wa1hco/rotator_controller/docs/design/drive-controller.md

# Drive controller

Design note, 2026-10-17, with the startup and brownout section added 2026-10-18. The decision records are [ADR 0020](../decisions/0020-drive-controller.md), status Accepted, and [ADR 0021](../decisions/0021-drive-startup-brownout.md), status Accepted. The 2026-10-18 schematic edit follows ADR 0021. The Drive sheets (`drive_mcu`, `analog_input`) and the pin table below were added after that. Firmware is unchanged.

The board gains a second MCU, the Drive. It is the virtual rotator: a short command interface, every deadline, and the same behavior when the STM32F407 is off, busy, or in the middle of an update. The F407 becomes the Station. It keeps the web UI, USB, Ethernet, GS-232, Hamlib, Easycom, the operator preset catalog, logging, parking schedules, multi-rotator, and firmware updates for both chips.

The principle for the split is: deadlines live in the Drive.

Decided in ADR 0020: the names Drive and Station; an AC axis is on or off, so its ramp time is 0; K1 stays, one ARM relay on the first board, because it is the only way to take a shorted triac off the bus; TR1, the ZMCT103C, stays as drawn; the heartbeat default is 5 seconds (allowed 2–30) and the default loss policy is stop; the Drive MCU is the STM32G431RBT6, LCSC C431633. ADR 0020 left ARM_OK as the residual gate. ADR 0021 accepts direct Drive pins, BOR level 4, and a hardware IWDG, and takes the supervisor and the Drive STOP pin off the rotor sheet. The rotor sheet matches that record. Section 8 is what is still open.

## 1. Names

**Drive** is the new MCU. **Station** is the STM32F407.

| Name | Chip | The word covers |
| --- | --- | --- |
| Drive | the new MCU | motors, sensing, brakes, and every deadline |
| Station | STM32F407VGT6, the chip in ADR 0014 | web UI, USB, Ethernet, operator protocols, logging, schedules, multi-rotator, updates |

The product is already called the rotator controller. Drive is the chip that fires the triacs, times the reversal, and still holds the limits when the Station is down. Station is the chip that faces the shack.

## 2. Who owns what

Deadlines live in the Drive. A deadline here means a time after which the hardware must already have done something: dead time before a reverse, ramp, brake release and engage, soft-limit stop, stall, jam, run timeout, and the heartbeat. The Station may be occupied with Ethernet, USB, the web UI, or a firmware upgrade. Those tasks do not extend a Drive deadline.

| Work | Drive | Station |
| --- | --- | --- |
| CW, CCW, and brake triac gates; ARM relay | owns | |
| Reversal dead time | owns | |
| Ramp states. AC ramp time is 0, so the axis is on or off. A real slope is the later DC H-bridge module (ADR 0018). | owns the states | |
| Soft limits and the overlap choice | owns | displays |
| Stall, jam, run timeout | owns | displays and logs |
| Position: pot ADC, filtering, calibration, pulse and quadrature inputs | owns | displays |
| Goto, jog, stop, and park execution | owns | translates GS-232, Hamlib, Easycom, and the web UI into those commands |
| Heartbeat and the loss policy | enforces | sends |
| Limits, calibration, park heading, ramps, deadlines, loss policy | flash copy that runs | operator copy and the preset catalog |
| The other chip off or wedged | runs the stored config and the loss policy | can reset and reflash the Drive; does not gate the triacs |
| Web UI, USB, Ethernet | | owns |
| GS-232, Hamlib, Easycom | | owns |
| Logging, parking schedules, multi-rotator | | owns |
| Firmware update | receives its image over the link | owns both updates |

Azimuth and elevation are two instances of one state machine. Elevation adds a second instance and, when the rotor needs it, a second power stage. ADR 0008 stays: an azimuth-only board leaves the elevation power stage unpopulated. The elevation machine stays in IDLE and reports itself absent.

One Drive serves one rotator (one or two axes) on one UART. A second rotator is a second Drive and a second UART on the Station. That is how multi-rotator stays a Station concern.

## 3. Link to the Station

### Physical layer

Both MCUs use the rotor-return ground. ADR 0018 set logic ground to CDE terminal 1 and left no isolated DC-DC between logic chips. USB stays isolated by the ADuM4160. Ethernet stays isolated by the MagJack. The Drive-to-Station link is on that same ground: 3.3 V, no isolator, no level shifter.

That ground is also the motor return. The link is a short trace, with the two chips placed near each other.

| Link | Wires | Fit |
| --- | --- | --- |
| UART | TX, RX, and the shared ground | Recommended. Either chip can send a status frame. A ground bounce corrupts a byte, and the CRC drops that frame. |
| SPI | SCK, MOSI, MISO, CS | Workable on a short board. Two extra wires, and a clocked transfer is an easy place to start streaming motion samples. The commands in this note are targets with an acknowledgement. |
| I2C | SCL, SDA | A poor fit on a motor return. A spike becomes an extra clock, and the protocol has no frame CRC. |

Assumption: 115200 baud, 8 data bits, no parity, one stop bit, using the MCU's internal oscillator. A crystal is optional; none is required for this baud on a short link.

### Frame

Proposed version 1:

| Field | Bytes | Contents |
| --- | --- | --- |
| SOF | 1 | `0xA5` |
| VER | 1 | `0x01` |
| SEQ | 1 | Host command sequence. Unsolicited status uses `0`. |
| OPCODE | 1 | Below. |
| LEN | 1 | Payload length, 0 to 128. |
| PAYLOAD | LEN | |
| CRC | 2 | CRC-16/CCITT-FALSE, polynomial `0x1021`, init `0xFFFF`, over VER through the payload, high byte first. |

Assumption: that CRC. A damaged frame is dropped with no reply, because the SEQ byte may be the damaged one.

### Sequence numbers

The Station sends one command and waits for the ACK of that SEQ. A retry repeats the same SEQ. The Station sends the next SEQ only after that ACK, and it retries only the SEQ it is waiting on.

The Drive stores `last_seq`. After reset, `last_seq` is 0 and the first CRC-good command may carry any non-zero SEQ. That value becomes `last_seq`.

Later frames:

- `SEQ == last_seq`: duplicate. ACK, and leave the payload unapplied.
- `SEQ == last_seq + 1` modulo 256, skipping 0: apply, then store it.
- any other SEQ: NACK `BAD_SEQ`. Leave the state and `last_seq` alone. The frame is not a heartbeat.

Unsolicited status uses SEQ 0 and stands outside that counter.

A lost command is retried under the same SEQ and applied once. A duplicate is acknowledged and applied once. After a newer SEQ has been accepted, an older SEQ is `BAD_SEQ` and cannot replace the newer target.

Each command names a target. GOTO replaces the heading. JOG replaces the direction and the speed. STOP replaces the goal with stopped. A late, repeated, or missing copy leaves the Drive on the last accepted target. The Drive does not integrate steps.

### Order inside a good frame

1. Apply the SEQ rules above.
2. HEARTBEAT, READ_STATUS, or any command while `host_lost` is clear: apply `heartbeat_ok` first.
3. A motion or config command while `host_lost` is set: NACK `HOST_LOST`. That frame does not clear the flag.
4. Otherwise apply the opcode as the event in the state table.

On a live link, a command refreshes the heartbeat. After a loss, only HEARTBEAT or READ_STATUS clears `host_lost`. The following command is then accepted. That is the "ignore new commands until the heartbeat returns" rule.

### Command set

Proposed opcodes:

| Opcode | Code | Payload |
| --- | --- | --- |
| HEARTBEAT | `0x01` | empty |
| GOTO | `0x02` | axis mask, azimuth in 0.01°, elevation in 0.01°, each a signed 32-bit value |
| STOP | `0x03` | axis mask |
| JOG | `0x04` | one axis bit, direction, speed in permille (`uint16`, 0–1000) |
| PARK | `0x05` | axis mask. The heading is the park value in Drive flash. |
| SET_LIMITS | `0x06` | axis, minimum, maximum, overlap flag |
| SET_CALIBRATION | `0x07` | axis, sensor kind, end readings, end headings. Byte layout TBD. |
| SET_PRESET | `0x08` | axis, park heading |
| SET_MOTION | `0x09` | ramp time (0 on an AC axis), creep window, target window, dead time, brake times, stall, jam, run timeout, heartbeat, loss policy |
| READ_STATUS | `0x0A` | empty. The ACK carries the status record. |
| CLEAR_FAULT | `0x0B` | axis mask |
| ENTER_BOOTLOADER | `0x0C` | a 32-bit magic. The constant is TBD, so a damaged payload cannot enter the bootloader. |
| STATUS | `0x10` | unsolicited status, SEQ 0 |
| ACK | `0x80` | echoes SEQ |
| NACK | `0x7F` | echoes SEQ and a reason byte |

NACK reasons: `BAD_SEQ`, `BAD_STATE`, `HOST_LOST`, `LIMIT`, `BAD_CONFIG`, `FAULT`, `AXIS_ABSENT`, `BAD_MAGIC`.

An AC axis is on or off. Its ramp time is 0, and CREEP commands the same full-on direction gate as RUN. Permille speed and a non-zero ramp belong to the later DC H-bridge module. The states in section 4 still run, and on AC the ramp states pass straight through. Heading unit and the permille encoding are still open (section 8).

Axis bit 0 is azimuth. Bit 1 is elevation.

`SET_LIMITS`, `SET_CALIBRATION`, `SET_PRESET`, and `SET_MOTION` are one event in the state table, `cmd_set_config`. They stay separate opcodes on the wire. A valid write replaces those fields and updates the config CRC. A duplicate SEQ does not write flash again.

### Status

READ_STATUS returns the record below. The Drive also sends it unsolicited. Assumption: every 100 ms while any axis has a heartbeat armed, and every 1 s in BOOT, IDLE, and FAULT.

Per axis: state, parked flag, direction, heading and a valid flag, target, held target (set when hold-on-loss abandons a goto), speed, dead time remaining, brake time remaining, ramp time remaining, CW and CCW limit flags, fault bits, `host_lost`, the loss policy, and a present flag.

Shared: current-transformer reading as raw ADC counts and as milliamps using the burden equation; config CRC-32; firmware major, minor, patch, and build id; protocol version; `last_seq`; FLASH_OPTR, so the Station can check the option bytes in ADR 0021.

DESIGN-NOTES already flags CT saturation at motor-plus-brake current. The milliamp field inherits that limit.

### Faults and flags

Latched fault bits. `clear_fault` clears a bit only when its cause is gone, and the axis stays in FAULT while any bit remains.

| Bit | When it sets |
| --- | --- |
| `CONFIG` | The stored config fails its check. |
| `STALL` | A direction gate is on and the heading stays inside the stall window for the stall time. A low-current detector can set the same bit. Thresholds TBD. |
| `JAM` | Current above the jam threshold. |
| `RUN_TIMEOUT` | This move has exceeded the configured maximum run. |
| `SENSOR` | The pot sample is outside the calibrated range, or the pulse input fails its check. |
| `STUCK_TRIAC` | Stuck-on sense says that triac is conducting after its gate has been off for 20 ms. That interval is the one already in DESIGN-NOTES. |
| `STOP` | A STOP command from the Station is accepted while the core is running. |
| `BOTH_ON` | The output step was asked for CW and CCW together. The state table does not ask for that. The check is defensive. |
| `OPTION_BYTES` | FLASH_OPTR disagrees with ADR 0021. The Drive leaves the outputs safe and the Station does not arm. |

`STUCK_TRIAC`, `JAM`, `SENSOR`, `STOP`, `CONFIG`, `STALL`, `RUN_TIMEOUT`, `BOTH_ON`, and `OPTION_BYTES` force the safe outputs in the same tick: both direction gates off, brake engaged, ARM relay open. They do not ramp down. Opening the ARM relay takes a shorted triac off the 26 VAC bus.

Flags, which are not faults: `HOST_LOST`, the two soft-limit flags, and `PARKED`.

## 4. Heartbeat and the axis machine

The host heartbeat is a deadline of seconds. The Drive's hardware independent watchdog is the separate, faster timer (about 100 ms once firmware has written the reload). A stuck Drive is that watchdog.

The heartbeat default is 5 seconds, set per rotor, allowed range 2 to 30 seconds. The default loss policy is stop. Hold and complete-the-move stay available as per-rotor settings.

The deadline arms when a move is accepted and disarms on entry to IDLE. An idle axis and a parked axis have no heartbeat deadline.

| Policy | Result of a missed heartbeat |
| --- | --- |
| stop | Leave the direction through `RAMP_DOWN` (immediate when the ramp time is 0), engage the brake, enter IDLE, set `host_lost`, and drop the goal. |
| hold | The same motion as stop. The abandoned heading stays in `held_target` for the Station to display. The axis does not continue. |
| complete | The goto or park already underway runs to IDLE. New commands wait for `heartbeat_ok`. A jog has no target, so a jog takes the stop path. |

### Outputs

Brake gate high means the solenoid releases the wedge, matching DESIGN-NOTES. Gate low means the wedge is engaged.

| State | Direction gates | Brake | ARM relay |
| --- | --- | --- | --- |
| BOOT | off | engaged | off |
| IDLE | off | engaged | off |
| BRAKE_RELEASE | off | releasing | on |
| RAMP_UP | one direction | released | on |
| RUN | one direction | released | on |
| CREEP | one direction | released | on |
| RAMP_DOWN | that same direction until `ramp_done`, then off | released | on |
| DEAD_TIME | off | released | on |
| BRAKE_ENGAGE | off | engaging | on until IDLE |
| FAULT | off | engaged | off |

CW and CCW are never both on. A tick that would turn both on latches `BOTH_ON` and enters FAULT.

An AC axis has ramp time 0. `RAMP_UP` and `RAMP_DOWN` are still entered, and `ramp_done` follows on the next tick, with the direction gate full on and then full off. A slope, and a creep speed below full on, are the later DC H-bridge module.

Dead time floor: 500 ms, the value already compiled in as `reversal_dead_time_ms` and `MotionConfig::dead_time_ms`. Changing the pending direction restarts the full interval. The interval is never shortened. STOP during `DEAD_TIME` waits the interval out, because a triac can stay latched until current zero.

Assumption, still open: during a reversal the brake stays released through `DEAD_TIME`, and it engages on the way to IDLE. Brake release and brake engage times are config fields. Their values are TBD. The 50 ms arm time and 150 ms stop time in the current host test are code defaults, not measured solenoid times.

Parked is a flag on IDLE. It is set when a park goal reaches IDLE inside the park window.

Overlap is chosen when a goto or park is accepted, from the heading, the target, the soft limits, and the overlap flag. The machine stores the choice as the direction.

One axis of the Drive. Solid edges are the motion path. Dashed edges are heartbeat loss under stop or hold. A complete-move loss stays on the solid path. Dotted edges are faults. On AC, RAMP_UP and RAMP_DOWN have ramp time 0.

The drawing is the motion path. The tables below are the full event list. Source for the figure: `docs/design/img/src/drive-controller-fsm.dot`.

These fields are context, not states: the goal (none, goto, jog, park), the direction, the pending direction, `after_ramp` (Stop or Reverse), `host_lost`, `held_target`, `parked`, and the loss policy.

A row is one accepted event. A duplicate SEQ never reaches the table. Command rows still say what happens when `host_lost` is already set, so that edge is visible.

`stop_input` faults every axis. TR1 stays one current transformer on the shared hot. A jam on that reading faults every axis whose gate is on. If no gate is on, it faults both axes, because the current was not commanded. The 5 A rating against about 7.3 A motor-plus-brake, and saturation, stay open. Every other event is per axis. A stuck triac is the triac of that axis.

Each state lists the same 23 events.

### BOOT

Safe outputs. Heartbeat disarmed. Motion commands wait for `boot_ok`.

| Event | Result |
| --- | --- |
| boot_ok | Config CRC valid and the sensor sample is inside its calibrated range: go to IDLE, parked clear, outputs stay safe. Otherwise this event is not raised. |
| config_invalid | Latch CONFIG. Gates off, ARM off, brake engaged, goal cleared. |
| cmd_goto | Reject BAD_STATE. |
| cmd_jog | Reject BAD_STATE. |
| cmd_stop | Reject BAD_STATE. |
| cmd_park | Reject BAD_STATE. |
| cmd_set_config | Reject BAD_STATE. Config changes wait until IDLE or FAULT. |
| cmd_clear_fault | ACK and ignore. No fault bits are set. |
| cmd_bootloader | Reject BAD_STATE. Boot has not finished. A CONFIG fault, once latched, accepts the bootloader from FAULT. |
| heartbeat_ok | Clear host_lost if it was set. Do not arm a deadline. Stay. |
| heartbeat_lost | Ignore. Boot is not a host move, and the heartbeat deadline is disarmed. |
| enter_creep | Ignore. Creep is entered from RUN. |
| target_reached | Ignore. |
| ramp_done | Ignore. |
| dead_time_elapsed | Ignore. |
| brake_time_elapsed | Ignore. |
| hit_soft_limit | Ignore. |
| stall | Ignore. The direction gate is off, so a stall timer is not running. |
| jam | Latch JAM. Gates off, ARM off, brake engaged, goal cleared. |
| run_timeout | Ignore. No move is in progress, so the run timer is disarmed. |
| sensor_fault | Latch SENSOR. Gates off, ARM off, brake engaged, goal cleared. |
| stuck_triac | Latch STUCK_TRIAC. Gates off, ARM off, brake engaged, goal cleared. |
| stop_input | Latch STOP. Gates off, ARM off, brake engaged, goal cleared. |

### IDLE

Brake engaged, ARM off. Heartbeat disarmed. `parked` may be set.

| Event | Result |
| --- | --- |
| boot_ok | Ignore. |
| config_invalid | Latch CONFIG. Gates off, ARM off, brake engaged, goal cleared. |
| cmd_goto | If host_lost is set: reject HOST_LOST and do not clear it. No legal path under the soft limits and the overlap flag: reject LIMIT. Heading already inside the target window: store the target, clear parked, stay. Otherwise clear parked, store the target and direction, arm the heartbeat, and go to BRAKE_RELEASE. |
| cmd_jog | If host_lost is set: reject HOST_LOST and do not clear it. Jog into a limit that is already active: reject LIMIT. Otherwise clear parked, set the jog goal and direction, arm the heartbeat, and go to BRAKE_RELEASE. |
| cmd_stop | ACK. Stay. The parked flag is unchanged. |
| cmd_park | If host_lost is set: reject HOST_LOST and do not clear it. Heading already inside the park window: set parked and stay. No legal path: reject LIMIT. Otherwise clear parked, set the park goal, arm the heartbeat, and go to BRAKE_RELEASE. |
| cmd_set_config | Validate the blob. Valid: store it, recompute the config CRC, stay. Invalid: reject BAD_CONFIG and keep the previous blob. |
| cmd_clear_fault | ACK and ignore. No fault bits are set. |
| cmd_bootloader | Accept. Outputs are already safe. Leave this machine and enter the bootloader. |
| heartbeat_ok | Clear host_lost if it was set. Do not arm a deadline. Stay. |
| heartbeat_lost | Ignore. Do not set host_lost. An idle or parked axis has no heartbeat deadline. A host_lost flag left by the move that just finished stays set until heartbeat_ok. |
| enter_creep | Ignore. Creep is entered from RUN. |
| target_reached | Ignore. |
| ramp_done | Ignore. |
| dead_time_elapsed | Ignore. |
| brake_time_elapsed | Ignore. |
| hit_soft_limit | Set the matching limit flag. Stay. |
| stall | Ignore. The direction gate is off, so a stall timer is not running. |
| jam | Latch JAM. Gates off, ARM off, brake engaged, goal cleared. |
| run_timeout | Ignore. No move is in progress, so the run timer is disarmed. |
| sensor_fault | Latch SENSOR. Gates off, ARM off, brake engaged, goal cleared. |
| stuck_triac | Latch STUCK_TRIAC. Gates off, ARM off, brake engaged, goal cleared. |
| stop_input | Latch STOP. Gates off, ARM off, brake engaged, goal cleared. |

### BRAKE_RELEASE

ARM on, brake releasing, directions off. Heartbeat armed.

| Event | Result |
| --- | --- |
| boot_ok | Ignore. |
| config_invalid | Latch CONFIG. Gates off, ARM off, brake engaged, goal cleared. |
| cmd_goto | If host_lost is set: reject HOST_LOST and do not clear it. Replace the goal with this goto. Update the pending direction. Stay. A heading that is already satisfied takes BRAKE_ENGAGE when the brake timer elapses. |
| cmd_jog | If host_lost is set: reject HOST_LOST and do not clear it. Replace the goal with this jog. Update the pending direction. Stay. A heading that is already satisfied takes BRAKE_ENGAGE when the brake timer elapses. |
| cmd_stop | If host_lost is set: reject HOST_LOST and stay. Otherwise clear the goal and go to BRAKE_ENGAGE. |
| cmd_park | If host_lost is set: reject HOST_LOST and do not clear it. Replace the goal with this park. Update the pending direction. Stay. A heading that is already satisfied takes BRAKE_ENGAGE when the brake timer elapses. |
| cmd_set_config | Reject BAD_STATE. Config changes wait until IDLE or FAULT. |
| cmd_clear_fault | ACK and ignore. No fault bits are set. |
| cmd_bootloader | Reject BAD_STATE. A move is in progress. |
| heartbeat_ok | Clear host_lost. Reload the heartbeat deadline. Stay. |
| heartbeat_lost | Stop: set host_lost, clear the goal and any pending reverse, and take the stop path. Stop path here is BRAKE_ENGAGE. Hold: same path as stop, and keep the abandoned target in held_target. Complete, goal is goto or park: set host_lost and stay on this trajectory. Complete, goal is jog: take the stop path, because a jog has no target. |
| enter_creep | Ignore. Creep is entered from RUN. |
| target_reached | Ignore. |
| ramp_done | Ignore. |
| dead_time_elapsed | Ignore. |
| brake_time_elapsed | Goal cleared, or the heading is already inside the target window: go to BRAKE_ENGAGE. Otherwise go to RAMP_UP with the pending direction. |
| hit_soft_limit | Pending direction runs into that limit: clear the goal, set the flag, go to BRAKE_ENGAGE. Otherwise set the flag and stay. |
| stall | Ignore. The direction gate is off, so a stall timer is not running. |
| jam | Latch JAM. Gates off, ARM off, brake engaged, goal cleared. |
| run_timeout | Latch RUN_TIMEOUT. Gates off, ARM off, brake engaged, goal cleared. |
| sensor_fault | Latch SENSOR. Gates off, ARM off, brake engaged, goal cleared. |
| stuck_triac | Latch STUCK_TRIAC. Gates off, ARM off, brake engaged, goal cleared. |
| stop_input | Latch STOP. Gates off, ARM off, brake engaged, goal cleared. |

### RAMP_UP

One direction on. On AC the ramp time is 0, so `ramp_done` is the next tick and the gate is already full on. A DC H-bridge module is what gives this state a slope.

| Event | Result |
| --- | --- |
| boot_ok | Ignore. |
| config_invalid | Latch CONFIG. Gates off, ARM off, brake engaged, goal cleared. |
| cmd_goto | If host_lost is set: reject HOST_LOST and do not clear it. Same direction and the target window is not already satisfied: replace the target or the jog speed and stay. Opposite direction, or the heading is already inside the window: go to RAMP_DOWN, after_ramp = Reverse or Stop. |
| cmd_jog | If host_lost is set: reject HOST_LOST and do not clear it. Same direction and the target window is not already satisfied: replace the target or the jog speed and stay. Opposite direction, or the heading is already inside the window: go to RAMP_DOWN, after_ramp = Reverse or Stop. |
| cmd_stop | If host_lost is set: reject HOST_LOST and stay. Otherwise clear the goal and any pending reverse, after_ramp = Stop, go to RAMP_DOWN. |
| cmd_park | If host_lost is set: reject HOST_LOST and do not clear it. Same direction and the target window is not already satisfied: replace the target or the jog speed and stay. Opposite direction, or the heading is already inside the window: go to RAMP_DOWN, after_ramp = Reverse or Stop. |
| cmd_set_config | Reject BAD_STATE. Config changes wait until IDLE or FAULT. |
| cmd_clear_fault | ACK and ignore. No fault bits are set. |
| cmd_bootloader | Reject BAD_STATE. A move is in progress. |
| heartbeat_ok | Clear host_lost. Reload the heartbeat deadline. Stay. |
| heartbeat_lost | Stop: set host_lost, clear the goal and any pending reverse, and take the stop path. Stop path here is RAMP_DOWN with after_ramp = Stop. Hold: same path as stop, and keep the abandoned target in held_target. Complete, goal is goto or park: set host_lost and stay on this trajectory. Complete, goal is jog: take the stop path, because a jog has no target. |
| enter_creep | Ignore. Creep is entered from RUN. |
| target_reached | Goto or park inside the target window: clear the direction goal's continue flag, after_ramp = Stop, go to RAMP_DOWN. A jog does not raise this event. |
| ramp_done | Go to RUN. The direction gate stays on. |
| dead_time_elapsed | Ignore. |
| brake_time_elapsed | Ignore. |
| hit_soft_limit | Traveling into that limit: set the flag, clear a pending reverse, after_ramp = Stop, go to RAMP_DOWN. |
| stall | Latch STALL. Gates off, ARM off, brake engaged, goal cleared. |
| jam | Latch JAM. Gates off, ARM off, brake engaged, goal cleared. |
| run_timeout | Latch RUN_TIMEOUT. Gates off, ARM off, brake engaged, goal cleared. |
| sensor_fault | Latch SENSOR. Gates off, ARM off, brake engaged, goal cleared. |
| stuck_triac | Latch STUCK_TRIAC. Gates off, ARM off, brake engaged, goal cleared. |
| stop_input | Latch STOP. Gates off, ARM off, brake engaged, goal cleared. |

### RUN

One direction at the commanded speed.

| Event | Result |
| --- | --- |
| boot_ok | Ignore. |
| config_invalid | Latch CONFIG. Gates off, ARM off, brake engaged, goal cleared. |
| cmd_goto | If host_lost is set: reject HOST_LOST and do not clear it. Same direction and the target window is not already satisfied: replace the target or the jog speed and stay. Opposite direction, or the heading is already inside the window: go to RAMP_DOWN, after_ramp = Reverse or Stop. |
| cmd_jog | If host_lost is set: reject HOST_LOST and do not clear it. Same direction and the target window is not already satisfied: replace the target or the jog speed and stay. Opposite direction, or the heading is already inside the window: go to RAMP_DOWN, after_ramp = Reverse or Stop. |
| cmd_stop | If host_lost is set: reject HOST_LOST and stay. Otherwise clear the goal and any pending reverse, after_ramp = Stop, go to RAMP_DOWN. |
| cmd_park | If host_lost is set: reject HOST_LOST and do not clear it. Same direction and the target window is not already satisfied: replace the target or the jog speed and stay. Opposite direction, or the heading is already inside the window: go to RAMP_DOWN, after_ramp = Reverse or Stop. |
| cmd_set_config | Reject BAD_STATE. Config changes wait until IDLE or FAULT. |
| cmd_clear_fault | ACK and ignore. No fault bits are set. |
| cmd_bootloader | Reject BAD_STATE. A move is in progress. |
| heartbeat_ok | Clear host_lost. Reload the heartbeat deadline. Stay. |
| heartbeat_lost | Stop: set host_lost, clear the goal and any pending reverse, and take the stop path. Stop path here is RAMP_DOWN with after_ramp = Stop. Hold: same path as stop, and keep the abandoned target in held_target. Complete, goal is goto or park: set host_lost and stay on this trajectory. Complete, goal is jog: take the stop path, because a jog has no target. |
| enter_creep | Goal is goto or park and the heading is inside the creep window: go to CREEP. A jog does not raise this event. |
| target_reached | Goto or park inside the target window: clear the direction goal's continue flag, after_ramp = Stop, go to RAMP_DOWN. A jog does not raise this event. |
| ramp_done | Ignore. |
| dead_time_elapsed | Ignore. |
| brake_time_elapsed | Ignore. |
| hit_soft_limit | Traveling into that limit: set the flag, clear a pending reverse, after_ramp = Stop, go to RAMP_DOWN. |
| stall | Latch STALL. Gates off, ARM off, brake engaged, goal cleared. |
| jam | Latch JAM. Gates off, ARM off, brake engaged, goal cleared. |
| run_timeout | Latch RUN_TIMEOUT. Gates off, ARM off, brake engaged, goal cleared. |
| sensor_fault | Latch SENSOR. Gates off, ARM off, brake engaged, goal cleared. |
| stuck_triac | Latch STUCK_TRIAC. Gates off, ARM off, brake engaged, goal cleared. |
| stop_input | Latch STOP. Gates off, ARM off, brake engaged, goal cleared. |

### CREEP

Inside the creep window of a goto or a park. On AC the gate stays full on, the same as RUN. A reduced creep speed is the later DC H-bridge module.

| Event | Result |
| --- | --- |
| boot_ok | Ignore. |
| config_invalid | Latch CONFIG. Gates off, ARM off, brake engaged, goal cleared. |
| cmd_goto | If host_lost is set: reject HOST_LOST and do not clear it. Same direction and the target window is not already satisfied: replace the target or the jog speed and stay. A new goto or park outside the creep window goes to RUN when the direction stays the same. Opposite direction, or the heading is already inside the window: go to RAMP_DOWN, after_ramp = Reverse or Stop. |
| cmd_jog | If host_lost is set: reject HOST_LOST and do not clear it. Same direction and the target window is not already satisfied: replace the target or the jog speed and stay. Opposite direction, or the heading is already inside the window: go to RAMP_DOWN, after_ramp = Reverse or Stop. |
| cmd_stop | If host_lost is set: reject HOST_LOST and stay. Otherwise clear the goal and any pending reverse, after_ramp = Stop, go to RAMP_DOWN. |
| cmd_park | If host_lost is set: reject HOST_LOST and do not clear it. Same direction and the target window is not already satisfied: replace the target or the jog speed and stay. A new goto or park outside the creep window goes to RUN when the direction stays the same. Opposite direction, or the heading is already inside the window: go to RAMP_DOWN, after_ramp = Reverse or Stop. |
| cmd_set_config | Reject BAD_STATE. Config changes wait until IDLE or FAULT. |
| cmd_clear_fault | ACK and ignore. No fault bits are set. |
| cmd_bootloader | Reject BAD_STATE. A move is in progress. |
| heartbeat_ok | Clear host_lost. Reload the heartbeat deadline. Stay. |
| heartbeat_lost | Stop: set host_lost, clear the goal and any pending reverse, and take the stop path. Stop path here is RAMP_DOWN with after_ramp = Stop. Hold: same path as stop, and keep the abandoned target in held_target. Complete, goal is goto or park: set host_lost and stay on this trajectory. Complete, goal is jog: take the stop path, because a jog has no target. |
| enter_creep | Ignore. Creep is entered from RUN. |
| target_reached | Goto or park inside the target window: clear the direction goal's continue flag, after_ramp = Stop, go to RAMP_DOWN. A jog does not raise this event. |
| ramp_done | Ignore. |
| dead_time_elapsed | Ignore. |
| brake_time_elapsed | Ignore. |
| hit_soft_limit | Traveling into that limit: set the flag, clear a pending reverse, after_ramp = Stop, go to RAMP_DOWN. |
| stall | Latch STALL. Gates off, ARM off, brake engaged, goal cleared. |
| jam | Latch JAM. Gates off, ARM off, brake engaged, goal cleared. |
| run_timeout | Latch RUN_TIMEOUT. Gates off, ARM off, brake engaged, goal cleared. |
| sensor_fault | Latch SENSOR. Gates off, ARM off, brake engaged, goal cleared. |
| stuck_triac | Latch STUCK_TRIAC. Gates off, ARM off, brake engaged, goal cleared. |
| stop_input | Latch STOP. Gates off, ARM off, brake engaged, goal cleared. |

### RAMP_DOWN

The direction that was on, then off. On AC the ramp time is 0, so `ramp_done` is the next tick. `ramp_done` starts dead time when a reverse is pending, and engages the brake when the axis is stopping.

| Event | Result |
| --- | --- |
| boot_ok | Ignore. |
| config_invalid | Latch CONFIG. Gates off, ARM off, brake engaged, goal cleared. |
| cmd_goto | If host_lost is set: reject HOST_LOST and do not clear it. Same direction as the ramp in progress: go to RAMP_UP. Opposite direction: stay, after_ramp = Reverse, and set the pending direction. Dead time starts only for that opposite direction, after ramp_done. Heading already inside the window: after_ramp = Stop, stay. |
| cmd_jog | If host_lost is set: reject HOST_LOST and do not clear it. Same direction as the ramp in progress: go to RAMP_UP. Opposite direction: stay, after_ramp = Reverse, and set the pending direction. Dead time starts only for that opposite direction, after ramp_done. Heading already inside the window: after_ramp = Stop, stay. |
| cmd_stop | If host_lost is set: reject HOST_LOST and stay. Otherwise clear the goal and any pending reverse, after_ramp = Stop, stay. |
| cmd_park | If host_lost is set: reject HOST_LOST and do not clear it. Same direction as the ramp in progress: go to RAMP_UP. Opposite direction: stay, after_ramp = Reverse, and set the pending direction. Dead time starts only for that opposite direction, after ramp_done. Heading already inside the window: after_ramp = Stop, stay. |
| cmd_set_config | Reject BAD_STATE. Config changes wait until IDLE or FAULT. |
| cmd_clear_fault | ACK and ignore. No fault bits are set. |
| cmd_bootloader | Reject BAD_STATE. A move is in progress. |
| heartbeat_ok | Clear host_lost. Reload the heartbeat deadline. Stay. |
| heartbeat_lost | Stop: set host_lost, clear the goal and any pending reverse, and take the stop path. Stop path here stays in RAMP_DOWN with after_ramp = Stop. Hold: same path as stop, and keep the abandoned target in held_target. Complete, goal is goto or park: set host_lost and stay on this trajectory. Complete, goal is jog: take the stop path, because a jog has no target. |
| enter_creep | Ignore. Creep is entered from RUN. |
| target_reached | Ignore. |
| ramp_done | Direction gate off. after_ramp is Reverse and a direction is pending: go to DEAD_TIME. Otherwise go to BRAKE_ENGAGE. |
| dead_time_elapsed | Ignore. |
| brake_time_elapsed | Ignore. |
| hit_soft_limit | Set the flag. Force after_ramp = Stop so ramp_done engages the brake. Stay. |
| stall | Direction gate still on: latch STALL, safe outputs. Gate already off: ignore. |
| jam | Latch JAM. Gates off, ARM off, brake engaged, goal cleared. |
| run_timeout | Latch RUN_TIMEOUT. Gates off, ARM off, brake engaged, goal cleared. |
| sensor_fault | Latch SENSOR. Gates off, ARM off, brake engaged, goal cleared. |
| stuck_triac | Latch STUCK_TRIAC. Gates off, ARM off, brake engaged, goal cleared. |
| stop_input | Latch STOP. Gates off, ARM off, brake engaged, goal cleared. |

### DEAD_TIME

Both directions off. Brake stays released. The timer is at least 500 ms and is never shortened.

| Event | Result |
| --- | --- |
| boot_ok | Ignore. |
| config_invalid | Latch CONFIG. Gates off, ARM off, brake engaged, goal cleared. |
| cmd_goto | If host_lost is set: reject HOST_LOST and do not clear it. Replace the goal with this goto and update the pending direction. Stay. Changing the pending direction restarts the full dead-time timer. The timer is never shortened, and RAMP_UP waits for dead_time_elapsed. |
| cmd_jog | If host_lost is set: reject HOST_LOST and do not clear it. Replace the goal with this jog and update the pending direction. Stay. Changing the pending direction restarts the full dead-time timer. The timer is never shortened, and RAMP_UP waits for dead_time_elapsed. |
| cmd_stop | If host_lost is set: reject HOST_LOST and stay. Otherwise clear the goal and the pending direction. Stay. The dead-time timer keeps running, and dead_time_elapsed then goes to BRAKE_ENGAGE. |
| cmd_park | If host_lost is set: reject HOST_LOST and do not clear it. Replace the goal with this park and update the pending direction. Stay. Changing the pending direction restarts the full dead-time timer. The timer is never shortened, and RAMP_UP waits for dead_time_elapsed. |
| cmd_set_config | Reject BAD_STATE. Config changes wait until IDLE or FAULT. |
| cmd_clear_fault | ACK and ignore. No fault bits are set. |
| cmd_bootloader | Reject BAD_STATE. A move is in progress. |
| heartbeat_ok | Clear host_lost. Reload the heartbeat deadline. Stay. |
| heartbeat_lost | Stop: set host_lost, clear the goal and any pending reverse, and take the stop path. Stop path here clears the pending direction and stays until dead_time_elapsed, which then goes to BRAKE_ENGAGE. The timer is not shortened. Hold: same path as stop, and keep the abandoned target in held_target. Complete, goal is goto or park: set host_lost and stay on this trajectory. Complete, goal is jog: take the stop path, because a jog has no target. |
| enter_creep | Ignore. Creep is entered from RUN. |
| target_reached | Ignore. |
| ramp_done | Ignore. |
| dead_time_elapsed | A direction is still pending and the goal was not cleared: go to RAMP_UP. Otherwise go to BRAKE_ENGAGE. |
| brake_time_elapsed | Ignore. |
| hit_soft_limit | Pending direction runs into that limit: clear the pending direction, set the flag, stay. dead_time_elapsed then goes to BRAKE_ENGAGE. |
| stall | Ignore. The direction gate is off, so a stall timer is not running. |
| jam | Latch JAM. Gates off, ARM off, brake engaged, goal cleared. |
| run_timeout | Latch RUN_TIMEOUT. Gates off, ARM off, brake engaged, goal cleared. |
| sensor_fault | Latch SENSOR. Gates off, ARM off, brake engaged, goal cleared. |
| stuck_triac | Latch STUCK_TRIAC. Gates off, ARM off, brake engaged, goal cleared. |
| stop_input | Latch STOP. Gates off, ARM off, brake engaged, goal cleared. |

### BRAKE_ENGAGE

Directions off, wedge engaging. A new move waits until IDLE.

| Event | Result |
| --- | --- |
| boot_ok | Ignore. |
| config_invalid | Latch CONFIG. Gates off, ARM off, brake engaged, goal cleared. |
| cmd_goto | If host_lost is set: reject HOST_LOST and do not clear it. Otherwise reject BAD_STATE. The brake timer finishes before a new move is accepted. The host retries; a retry is the same target. |
| cmd_jog | If host_lost is set: reject HOST_LOST and do not clear it. Otherwise reject BAD_STATE. The brake timer finishes before a new move is accepted. The host retries; a retry is the same target. |
| cmd_stop | If host_lost is set: reject HOST_LOST and stay. Otherwise ACK and stay. The brake timer keeps running. |
| cmd_park | If host_lost is set: reject HOST_LOST and do not clear it. Otherwise reject BAD_STATE. The brake timer finishes before a new move is accepted. The host retries; a retry is the same target. |
| cmd_set_config | Reject BAD_STATE. Config changes wait until IDLE or FAULT. |
| cmd_clear_fault | ACK and ignore. No fault bits are set. |
| cmd_bootloader | Reject BAD_STATE. A move is in progress. |
| heartbeat_ok | Clear host_lost. Reload the heartbeat deadline. Stay. |
| heartbeat_lost | Every policy: set host_lost and stay. The brake timer still runs to IDLE. New motion commands are rejected until heartbeat_ok. |
| enter_creep | Ignore. Creep is entered from RUN. |
| target_reached | Ignore. |
| ramp_done | Ignore. |
| dead_time_elapsed | Ignore. |
| brake_time_elapsed | Go to IDLE. ARM off. Disarm the heartbeat. Goal was park and the heading is inside the park window: set parked. |
| hit_soft_limit | Set the flag. Stay. |
| stall | Ignore. The direction gate is off, so a stall timer is not running. |
| jam | Latch JAM. Gates off, ARM off, brake engaged, goal cleared. |
| run_timeout | Latch RUN_TIMEOUT. Gates off, ARM off, brake engaged, goal cleared. |
| sensor_fault | Latch SENSOR. Gates off, ARM off, brake engaged, goal cleared. |
| stuck_triac | Latch STUCK_TRIAC. Gates off, ARM off, brake engaged, goal cleared. |
| stop_input | Latch STOP. Gates off, ARM off, brake engaged, goal cleared. |

### FAULT

Safe outputs, latched. `clear_fault` returns to IDLE only when every cause is gone.

| Event | Result |
| --- | --- |
| boot_ok | Ignore. |
| config_invalid | Stay. Set CONFIG. |
| cmd_goto | Reject FAULT. |
| cmd_jog | Reject FAULT. |
| cmd_stop | Reject FAULT. |
| cmd_park | Reject FAULT. |
| cmd_set_config | Validate the blob. Valid: store it, recompute the config CRC, stay. Invalid: reject BAD_CONFIG and keep the previous blob. |
| cmd_clear_fault | Clear each fault bit whose cause is gone. No bits left: go to IDLE. Any bit left: stay in FAULT. |
| cmd_bootloader | Accept. Outputs are already safe. Leave this machine and enter the bootloader. |
| heartbeat_ok | Clear host_lost if it was set. Do not arm a deadline. Stay. |
| heartbeat_lost | Ignore. Do not set host_lost. The outputs are already safe. |
| enter_creep | Ignore. Creep is entered from RUN. |
| target_reached | Ignore. |
| ramp_done | Ignore. |
| dead_time_elapsed | Ignore. |
| brake_time_elapsed | Ignore. |
| hit_soft_limit | Ignore. |
| stall | Ignore. The direction gate is off, so a stall timer is not running. |
| jam | Stay. Set JAM. clear_fault leaves the bit set while the cause is present. |
| run_timeout | Ignore. No move is in progress, so the run timer is disarmed. |
| sensor_fault | Stay. Set SENSOR. clear_fault leaves the bit set while the cause is present. |
| stuck_triac | Stay. Set STUCK_TRIAC. clear_fault leaves the bit set while the cause is present. |
| stop_input | Stay. Set STOP. clear_fault leaves the bit set while the cause is present. |

## 5. Hardware

### Drive MCU

The Drive MCU is the STM32G431RBT6. The other two rows are the parts checked against it on the LCSC pages on 2026-10-17. Warehouse stock moves, and it is not a promise. JLC's own assembly stock was not rechecked; confirm it before ordering. ADR 0013 still holds: JLCPCB assembles the SMT parts, so an LQFP does not have to be hand-soldered.

| Part | LCSC | Package | I/O | Core and memory | Analog, as listed on the LCSC page | Warehouse stock | Qty-1 price |
| --- | --- | --- | --- | --- | --- | --- | --- |
| STM32G431RBT6 | [C431633](https://www.lcsc.com/product-detail/C431633.html) | LQFP-64, 10×10 | 52 | Cortex-M4F, 170 MHz, 128 KB flash. The key line says 32 KB SRAM; the feature list splits that into 22 KB SRAM plus 10 KB CCM. | 2 ADCs, 0.25 µs, up to 16-bit with oversampling; 4 comparators; 3 op-amps; VREFBUF at 2.048 V, 2.5 V, or 2.95 V; quadrature encoder timers; 4 USART | 2,572 | $5.7997 |
| STM32G431CBT6 | [C529355](https://www.lcsc.com/product-detail/C529355.html) | LQFP-48, 7×7 | 38 | Same flash and core | Same analog list | 4,642 | $5.1654 |
| STM32G071RBT6 | [C432213](https://www.lcsc.com/product-detail/C432213.html) | LQFP-64, 10×10 | 60 | Cortex-M0+, 64 MHz, 128 KB flash, 36 KB SRAM | One 12-bit ADC, 0.4 µs, up to 16 external channels; two comparators | 788 | not copied off the page |

The Drive is the **STM32G431RBT6, LCSC C431633.** Two ADCs can take the pot ends and the current transformer without folding them into one long scan. The comparators and op-amps are available for the jam path and the pot front end. VREFBUF is a concrete candidate for the ADC reference ADR 0018 left open. Fifty-two I/O pins cover azimuth and elevation with room left. The 48-pin G431 (C529355) and the G071 (C432213) were the parts checked against it on 2026-10-17. JLC assembly stock was not rechecked; confirm it before ordering.

The accepted part is the 128 KB STM32G431RBT6. A 512 KB STM32G474 in LQFP-64 was not opened for this note, and it has no C-number here.

The Station is already an STM32F407 (ADR 0014). The Drive is a second chip. Other MCU families were not given C-numbers here.

### Pins

Assumption: the first board pins both axes. Elevation power parts can stay off the board.

| Function | Azimuth | Elevation | Shared |
| --- | --- | --- | --- |
| CW gate, into the 2N7002, with a pulldown | 1 | 1 | |
| CCW gate | 1 | 1 | |
| Brake gate, high = release | 1 | 1 | |
| ARM relay FET | | | 1 |
| Pot end A, ADC | 1 | 1 | |
| Pot end B, ADC | 1 | 1 | |
| Pulse, or quadrature A, timer input | 1 | 1 | |
| Quadrature B | 1 | 1 | |
| Stuck-on sense, CW, CCW, brake | 3 | 3 | |
| Optional limit inputs | 2 | 2 | |
| Zero-cross | | | 1 |
| Current transformer, ADC | | | 1 |
| UART TX and RX to the Station | | | 2 |
| PB8 / BOOT0. With nSWBOOT0 = 0 (ADR 0021) the boot selection is the option bit. PB8 is not a gate. | | | 1, spare |
| Status LED | | | 1, optional |
| SWDIO, SWCLK, and NRST | | | header |

Without the optional limit inputs that is about 30 signals plus the SWD header. The 64-pin part lists 52 I/O. The 48-pin part lists 38, which covers the cut above and leaves little spare. SWD uses two of those I/O.

The pot wiper is rotor return (ADR 0018). The Drive measures the two ends. A passive 60 Hz twin-T is drawn on each sense line of `analog_input`, ahead of the ADC. The FIR described in the system overview is not written yet. Firmware averaging is not the fix for the 60 Hz that the shared return wire puts on these lines.

### Pin assignment

Drawn on `hardware/controller-f407/drive_mcu.kicad_sch`. Package is LQFP-64. Pin numbers are DS12589 Table 12. Gate pins are high-Z at reset (DS12589 §3.11.5, RM0440 §9.4.1) and one pulldown per line already on `rotor_drive` holds them down: R2G, R3G, R4G, and R40. This sheet does not add another.

These pins are not gates: PA13, PA14, PA15, PB3, PB4 (debug), PG10 (NRST), PB8 (BOOT0, spare while nSWBOOT0 = 0), and every pin AN2606 Table 115 drives or pulls. That includes PA6 and PB14, which the ROM bootloader drives to 3.3 V. Those pins are no-connects on this sheet. PB3 is SWO on the debug header, not a gate.

| Signal | Pin | Use |
| --- | --- | --- |
| `AZ_CW_EN` | PC6, pin 38 | CW gate. High-Z at reset. |
| `AZ_CCW_EN` | PC7, pin 39 | CCW gate. |
| `AZ_BRAKE_EN` | PC12, pin 54 | Brake gate. High releases the wedge. |
| `ARM_EN` | PD2, pin 55 | K1 gate. Low or high-Z leaves the relay open. |
| `ZC_SENSE` | PB5, pin 58 | Zero-cross input. |
| `AZ_CW_SNS` | PC13, pin 2 | Stuck-on sense, CW. |
| `AZ_CCW_SNS` | PC14, pin 3 | Stuck-on sense, CCW. |
| `AZ_BRAKE_SNS` | PC15, pin 4 | Stuck-on sense, brake. |
| `AZ_A_ADC` | PC0, pin 8, ADC12_IN6 | Azimuth pot end A. |
| `AZ_B_ADC` | PC1, pin 9, ADC12_IN7 | Azimuth pot end B. |
| `EL_A_ADC` | PC2, pin 10, ADC12_IN8 | Elevation pot end A. |
| `EL_B_ADC` | PC3, pin 11, ADC12_IN9 | Elevation pot end B. |
| `I_SENSE` | PA0, pin 12, ADC12_IN1 | TR1, after the conditioning on `rotor_drive`. |
| `VIN_WARN` | PA1, pin 13, COMP1_INP | AC-loss comparator. COMP1_INM is the internal 1/4 VREFINT, not a second pin. |
| Station TX | PB10, pin 30, USART3_TX AF7 | 3.3 V UART. Not the Table 115 USART3 pair (PC10/PC11). |
| Station RX | PB11, pin 33, USART3_RX AF7 | 3.3 V UART. |
| SWDIO | PA13, pin 49 | Cortex header J10. |
| SWCLK | PA14, pin 50 | Cortex header J10. |
| SWO | PB3, pin 56 | Cortex header J10. Not a gate. |
| NRST | PG10, pin 7 | J10 pin 10, with C108. No BOOT0 pin on the header. |

Clock is the internal HSI16. DS12589 Table 42 is ±1% from 0 to 85 °C, which is enough for this UART. There is no HSE and no LSE. The Drive has no USB, and the RTC is unused, so ES0431 §2.2.3 does not apply to the IWDG's LSI. A later RTC follows ADR 0021: LSE or HSE/32, LSECSSON clear. No crystal is on the sheet, and no crystal C-number is invented here.

`J10` is a Cortex 2×5 1.27 mm header (pins 1 VTREF, 2 SWDIO, 3 GND, 4 SWCLK, 5 GND, 6 SWO, 7 key, 8 no-connect, 9 GND, 10 nRESET). `J11` is a 4-pin 3.3 V UART (1 ground, 2 +3V3, 3 TX from PB10, 4 RX to PB11). ADR 0020 shares rotor-return ground, so this revision has no isolator. The connector, and any later isolator, are TBD. Both headers are through-hole and come from Mouser; the Mouser numbers are TBD.

VBAT (pin 1) is tied to VDD. VDD is pins 16, 32, 48, and 64, each with 100 nF (C100–C103) and a shared 4.7 µF (C104). VSS is pins 15, 31, 47, and 63. VSSA is pin 27. VDDA is pin 29 and VREF+ is pin 28. On LQFP-64 those two are separate pins. R100 (10 Ω) feeds both from digital +3V3, with C106 (100 nF) and C107 (1 µF) to ground. That filter is the ADC reference, not a safety timer. VREFBUF versus this filtered 3.3 V is still open (section 8). The sheet uses the filtered 3.3 V. PF0 and PF1 are no-connects. Every new passive on this sheet is LCSC TBD. The MCU is LCSC C431633.

### Analog front end

Drawn on `hardware/controller-f407/analog_input.kicad_sch`. The pot path is a measurement. The RC there is an anti-alias filter, not a safety timer. The VIN_RECT path has no capacitor and no gate logic.

Each pot end is 330 Ω from +3V3, then 1 kΩ, then a 60 Hz twin-T, then 10 kΩ and 100 nF, then a BAT54 to +3V3 and a BAT54 to ground. The clamps are after the notch so they do not clip the 60 Hz before the filter can remove it. Azimuth ends are `AZ_POT_3` and `AZ_POT_7`. Their SMAJ90CA clamps (D6, D7) stay on `rotor_drive`. The wiper is `ROTOR_RETURN`. Elevation uses the same front end. The connector is `J5`, value `ELEVATION ROTOR` (pin 1 wiper to `ROTOR_RETURN`, pin 2 end A, pin 3 end B), through-hole, Mouser TBD. `D19` and `D22` on that cable are SMAJ90CA, LCSC C5353147, the same part as D6 and D7. The 330 Ω, 1 kΩ, 10 kΩ, 100 nF, and BAT54 parts are LCSC TBD.

The twin-T is R, R, and R/2, with C, C, and 2C. The values are 121 kΩ, 121 kΩ, and 60.4 kΩ, all 1%, with 22 nF C0G 1% 50 V 0805, and the shunt capacitor is two of those 22 nF in parallel so the capacitor ratio stays exact. Ideal half of 121 kΩ is 60.5 kΩ; 60.4 kΩ is the E96 value (60.4/60.5 = 0.998). Notch frequency 1/(2π·121 kΩ·22 nF) is 59.79 Hz. The 1 kΩ source is small next to 121 kΩ, and the ADC after the 10 kΩ is high impedance. The 100 nF is not high impedance at 60 Hz against 121 kΩ, so it stays as drawn and it sets the bandwidth: the twin-T's low-frequency output resistance is about 242 kΩ in series with the 10 kΩ, into 100 nF, about 4.7 Hz. A unit step at the ADC is inside 1% after 0.157 s and finishes at 1.000. DC gain is 1.000.

With the 60.4 kΩ shunt, the gain at 60 Hz at the ADC pin is 3.71×10⁻⁴, which is −68.6 dB. Five volts peak of 60 Hz on the line is 1.86 mV peak at the pin. The BAT54s do not conduct on that residue. At ±1% the notch moves: C +1% is −56.2 dB (7.7 mV peak), C −1% is −61.8 dB (4.1 mV), R and R/2 both +1% is −56.3 dB (7.7 mV), and both R and C +1% is −51.3 dB (13.5 mV peak). A 5% capacitor would be too shallow, so the capacitors are C0G 1%, not X7R.

SMT parts, confirmed as real LCSC numbers (stock was thin; confirm before ordering): 121 kΩ 0603 is LCSC C4280654 (Vishay CRCW0603121KFKTC); 60.4 kΩ 0603 is LCSC C844800 (Vishay CRCW060360K4FKEA); 22 nF C0G ±1% 50 V 0805 is LCSC C2259101 (KEMET C0805X223F5GEC7800). Do not substitute Yageo CC0805JRNPO9BN220 (that is 22 pF) or an X7R 22 nF.

TR1 and its bias and clamps stay on `rotor_drive`. That is the owner's decision. `analog_input` carries `I_SENSE` across to `I_ADC` on a wire, with no second copy of that circuit.

`VIN_WARN` is 39.0 kΩ over 1.00 kΩ, both 1%, from `VIN_RECT` to ground, clamped by BAT54 to +3V3 and to ground, into PA1. There is no capacitor. The comparator's other input is internal 1/4 VREFINT (DS12589 Table 20: VREFINT 1.182 / 1.212 / 1.232 V; the 1/4 divider is 24–26%). Typical trip is about 12.1 V at the rectifier. Across that table, the 1/4 range, the ES0431 §2.6.1 offset (−20 mV to +3 mV), and the 1% resistors, the trip is about 10.3 V to 13.2 V. That is below the 18 V brake-sag floor and above the buck's 6 V floor. At 48 V the pin is about 1.2 V. The two resistors and the two BAT54s are LCSC TBD.

The ADC reference on this board is the filtered 3.3 V on VREF+, described with the MCU. It is not VREFBUF.

Sensor kinds to pin now, from ADR 0008: dual-end pot, single-ended pot with an excitation GPIO, pulse or reed, and quadrature. The connector positions for the kinds the first cable does not use are TBD (section 8).

### What remains hardware on a reset

A Drive that is held in reset, or whose pins are high-Z, has to drop the triac gates and the ARM relay with no firmware running. The brake stays fail-engaged: gate low, solenoid open, wedge in.

ADR 0020 chose pulldowns plus an ARM_OK gate. ADR 0021 accepts the pulldowns alone on the triac gates and on the relay FET. The direction lockout, the RC hold, the TPS3823, and the STOP pin are off the sheet. The both-on window that remains is the hardware IWDG period while the core is still executing: about 100 ms after the reload is programmed, and about 0.5 s from a cold power-on until that write. Dead time stays in `DEAD_TIME`.

The triac pins are plain GPIO. Reset makes them analog (DS12589 §3.11.5, RM0440 §9.4.1), and R2G, R3G, and R4G, one pulldown each, hold the 2N7002 gates down. With the pin high-Z, that holds while +5 V is still up and 3.3 V is below POR. A short from a gate net to 3.3 V or to 5 V, or a bootloader pin AN2606 Table 115 drives high, still holds that triac on. The IWDG returns the MCU pin to analog. It does not clear a short on the far side of the pin.

A shorted power triac is the stuck-on sense plus K1. Opening K1 is the only way off the 26 VAC bus. `ARM_EN` low or high-Z opens K1 through R40. Q1 is an AO3400A, VGS(th) minimum 0.65 V, so a gate that sits above that while +5 V is up can start to conduct. A relay FET that is itself shorted on leaves the bus live.

STOP is a software command from the Station or the GUI. The Drive has no STOP pin. While the core is running, the command drops the gates, engages the brake, and opens K1. A stuck Drive is the hardware IWDG. A physical emergency stop is the user's power switch or the AC feed.

### Startup and brownout

The citations are ADR 0021. This is the sequence the sheet and the firmware follow.

1. Below POR, and below VBOR0, DS12589 does not guarantee the pins. With the pin high-Z, the pulldowns hold each 2N7002 off (VGS(th) minimum 1 V) even while +5 V is still up, and R40 holds Q1 off. A gate driven high by something other than the MCU is the case that fails, on the triacs and on the relay. Q1 can also begin to conduct above its 0.65 V VGS(th) minimum if the pin is not high-Z. K1's open contact covers an unpowered coil.
2. BOR level 4 (option byte `BOR_LEV` = 100) holds reset until VDD rises through VBOR4, 2.85 / 2.90 / 2.95 V (DS12589 Table 19). Falling, reset returns at 2.76 / 2.81 / 2.86 V. That is above the 2.7 V at which Table 54 guarantees VOL and VOH at 8 mA, so the pins go analog before the 8 mA drive specification is left behind. Non-debug pins are floating inputs (Table 11). The external pulldowns define them.
3. Option bytes load. The accepted word is 0xFBEEFCAA, from production 0xFFEFF8AA with IWDG_SW = 0, nSWBOOT0 = 0, and BOR_LEV = 100. nBOOT0 stays 1, so main flash is selected (RM0440 Table 5). The hardware IWDG is already counting. At the power-on reload (PR = /4, RL = 0xFFF) the timeout is 512 ms at 32 kHz, about 482 ms at 34 kHz, and about 555 ms at 29.5 kHz (DS12589 Tables 44 and 79).
4. Firmware pets the IWDG, writes PR = /4 and RL = 799, and pets again. The running timeout is (800 × 4) / fLSI: 100 ms at 32 kHz, about 94 ms at 34 kHz, about 109 ms at 29.5 kHz. It dummy-reads SRAM before the first write (ES0431 §2.2.7). It checks FLASH_OPTR and, on a mismatch, sets `OPTION_BYTES` and never enables an output.
5. `ARM_EN` is Q1's gate. Low or high-Z leaves K1 open. Firmware raises it only after the option-byte check passes.
6. A falling VIN_RECT, divided and clamped into a comparator, interrupts while the core is still up. Firmware drives CW and CCW low, the brake gate low, and `ARM_EN` low. The PVD watches VDD. VPVD6 falling (min 2.84 V) overlaps VBOR4 falling (max 2.86 V), so the VIN_RECT warning is the comparator. The divider is on `analog_input`: 39.0 kΩ over 1.00 kΩ, no capacitor, into PA1, compared with internal 1/4 VREFINT. Typical trip is about 12.1 V.
7. An IWDG timeout returns the pins to analog. The pulldowns turn the triacs off, engage the brake, and open K1. That is how a stuck Drive is handled.

Gate pins, when assigned, avoid the reset-time debug pins (PA13, PA14, PA15, PB3, PB4), PG10-NRST, PB8, and every pin AN2606 Table 115 configures. That table drives PA6 and PB14 to 3.3 V during system-memory boot, and it pulls several USART and I2C pins up. nSWBOOT0 = 0 keeps a floating PB8 from entering that boot.

The sheet clocks the core from HSI16 and leaves the RTC unused, so ES0431 §2.2.3 does not move the IWDG's LSI. A later RTC is LSE or HSE/32 with LSECSSON clear, which is the ADR 0021 workaround. Arming state stays out of the backup domain (ES0431 §2.2.6).

### Programming and update

The Drive has its own 2×5 1.27 mm SWD header, Cortex pinout, separate from the F407. Erratum ES0431 §2.2.1 says to use SWD.

With nSWBOOT0 = 0 the Station cannot force the ROM bootloader by driving PB8. Field update is a command the running Drive accepts, or SWD. `ENTER_BOOTLOADER` magic stays TBD (section 8). AN2606 §4.8: if the hardware IWDG is already on, the bootloader stretches the prescaler to /256 and refreshes the counter, so a bootloader session does not reset-loop. It can leave PVU set for the application that follows.

The factory word has IWDG_SW = 1. The first image pets the watchdog and then programs 0xFBEEFCAA. After that, the Station checks FLASH_OPTR in the status record and refuses to arm on a mismatch.

### Parts that leave, and parts that stay

U2, the direction AND gates, and the hold RC left in the ARM_OK schematic edit. ADR 0021 also removes U3, U6, U9, and U10 (74LVC1G08, LCSC C12512) and C3, C6, C9, and C10.

The 2026-10-17 netlist, taken before those edits, had an open CCW hold (`/HOLD_CCW` was only U2 pin 9). That network is gone. It was not repaired.

Stays:

- MOC3023 optos, triacs, gate resistors, and snubbers (ADR 0004). Q2, Q3, and Q4 still switch the LEDs from +5 V. The Drive pin drives the FET gate.
- K1, one relay, plus Q1 (AO3400A, LCSC C20917) and the flyback diode. `ARM_EN` drives Q1 through R40, the one pulldown on that net. R2G, R3G, and R4G are the one pulldown each on the triac gates. Coil off, the rotator is dark. K1 stays because it is the only way to end a shorted-triac fault. The G5LE-1A4 5 A inductive rating against about 7.3 A motor-plus-brake overlap stays open.
- U14, U15, and U16 stuck-on sense; U17 zero-cross; TR1, the Zeming ZMCT103C, and the `I_SENSE` bias and clamps. TR1 stays as drawn. Its 5 A rating and saturation stay open.
- Pot clamps, the SMAJ90CA parts, the fuse, and the MOV.
- The F407, the ADuM4160, and the MagJack.
- One pulldown per line: R2G, R3G, R4G, and R40.

Leaves with this edit, on top of the AND gates: U1 (TPS3823-33, LCSC C7719), C21, R41, R42, Q8 (MMBT3904, LCSC C20526), Q9, R54, R55, R56, and the sheet pins `STOP_N`, `WDI_KICK`, and `nRESET`.

## 6. Where the current interlock goes

| Rule today (DESIGN-NOTES, ADR 0005) | In this design |
| --- | --- |
| `ARM_OK = ARM_EN AND nRESET` | Removed (ADR 0021). The triac gates and the relay FET follow the Drive pins, with pulldowns. |
| `CW_GATE = AZ_CW_EN AND NOT AZ_CCW_EN AND ARM_OK AND NOT HOLD_CCW`, and the CCW mirror | One direction gate, and only in `RAMP_UP`, `RUN`, `CREEP`, and the gated part of `RAMP_DOWN`. The pin is the gate. |
| U4 is `AZ_CW_EN AND nCCW`, because ANDing a signal with its own inversion would never turn on | The running direction and the pending direction are data in the machine. The eight-gate network leaves. |
| RC hold, calculated near 92 ms, design window 70–110 ms | Removed. `DEAD_TIME` is the gap, floor 500 ms. |
| Firmware dead time at least 500 ms, longer than the hardware gap | The Drive timer is that gap. There is no shorter RC behind it. |
| `BRK_GATE = AZ_BRAKE_EN AND ARM_OK`, high = release | `BRAKE_RELEASE` and the released states drive the brake pin high. Low, or a high-Z pin, engages the wedge. |
| Watchdog, brownout, or STOP drops the brake gate and the wedge engages | An IWDG reset or BOR returns the brake pin to analog and the pulldown engages the wedge. A STOP command from the Station, while the core is running, drives the brake gate low and opens K1. |
| 100 kΩ pulldowns on the four request pins | Pulldowns on the Drive outputs. |
| ARM relay in series with the triac bus. Normal motion does not break load current in that contact. It opens on a fault. | K1 stays, one relay on the first board. It is the only way to end a shorted-triac fault. `FAULT` and reset open it. The 5 A versus about 7.3 A overlap rating stays open. |
| Stuck-on sense: armed, that gate off, no pulse for 20 ms | `STUCK_TRIAC`, same 20 ms, then ARM off. |
| WDI kicked faster than 0.9 s. R41 makes a floating WDI time out. | The hardware IWDG replaces that kick. The host heartbeat is the slower, separate deadline. |
| Current `MotionController`: direction outputs off except in the two Running states, which are never active together | Kept, and applied to every state in the output table. |

The code in the tree uses a smaller state set. The later software change maps it like this:

| `MotionState` today | Proposed state |
| --- | --- |
| Idle | IDLE |
| Arming | BRAKE_RELEASE |
| DeadTime | DEAD_TIME |
| RunningClockwise, RunningCounterClockwise | RAMP_UP, RUN, or CREEP. Direction is data. |
| Stopping | RAMP_DOWN, then BRAKE_ENGAGE |
| Fault | FAULT |
| (none) | BOOT |

`request_stop` today steps Fault straight to Idle. The proposal uses `clear_fault`, and only after the cause is gone.

DESIGN-NOTES places D2, the SMAJ90CA, on `AC_BUS`. The 2026-10-17 netlist places D2 pin 2 on `AC_FUSED` and D2 pin 1 on `GNDPWR`. K1 pin 1 is on `AC_FUSED` and K1 pin 3 is on `AC_BUS`. This proposal does not move D2 (section 8).

## 7. Software

The state machine is shared C++17. One function takes the state, the context, the event, the config, the time, and the sensor sample, and returns the next state, the context, the gate command, and the status fields. That function includes no STM32 headers and no Arduino headers, and it does not sleep or touch pins.

It lives in `software/firmware`, next to `rotator::motion::MotionController`. Suggested name: `rotator::motion::AxisFsm`. The current controller stays in the tree until `AxisFsm` replaces it. This proposal does not edit those sources.

The Drive firmware is the platform layer around that function: ADC, GPIO, UART, flash, and the independent watchdog. It calls `AxisFsm` on a tick. The PC test binary calls the same function. The Station firmware does not. It translates GS-232, Hamlib, Easycom, the web UI, and schedules into the opcodes in section 3.

`software/sim` is the physics side of the hardware-in-loop plan in section 4. It is still a separate program, copied from the K3NG-derived simulator, and it is not linked to `software/firmware` today. The later adapter feeds the simulator's heading and current in as sensor samples and applies the gate command as the simulator's motor request. Stall, backlash, and a stuck relay are already behaviors of that model.

### Test plan

The 230 rows are the unit-test list: one host test per row. These scripts sit on top of the rows:

- A reversal visits `RAMP_DOWN`, `DEAD_TIME`, and `RAMP_UP`. The dead-time timer is at least the configured floor. STOP during `DEAD_TIME` does not shorten it. Changing the pending direction restarts the full interval.
- On every tick of that script, including the transition ticks, CW and CCW are never both commanded.
- An AC profile, ramp time 0, still enters `RAMP_UP` and `RAMP_DOWN` and leaves each on the next tick, with the gate full on and then full off.
- A duplicate SEQ applies a GOTO once and does not restart the brake timer.
- A SEQ other than `last_seq` or the next one is rejected, and the state is unchanged.
- A dropped frame, retried with the same SEQ, applies once.
- Sitting in IDLE longer than the heartbeat timeout does not move the axis and does not set `host_lost`.
- Loss under stop, hold, and complete, each from `RUN`, from `DEAD_TIME`, and from `BRAKE_RELEASE`.
- Complete-policy loss during a jog takes the stop path.
- Stall, jam, stuck triac, and STOP from a gated state end in FAULT with ARM off and the brake engaged.
- Boot with a bad config CRC ends in FAULT and rejects GOTO.
- `clear_fault` while the sensor is still failed stays in FAULT.

Two PC benches use that same function:

1. The host tests under `software/firmware`.
2. The physics adapter into `software/sim`, described above.

A third fixture checks the framer only: a bad CRC, a dropped byte, a duplicate, and a delayed older SEQ.

None of that code is in this change.

## 8. Open questions

Settled, and removed from this list: a passive 60 Hz twin-T on each pot sense line (121 kΩ / 60.4 kΩ / 22 nF C0G, clamps after the filter); the names Drive and Station; AC axes on or off with ramp time 0; K1 stays, one relay on the first board; TR1 and its conditioning stay on `rotor_drive`, and `analog_input` only carries `I_SENSE` to the ADC; one pulldown per gate line (R2G, R3G, R4G, R40); heartbeat default 5 seconds (range 2–30) with loss policy stop; Drive MCU STM32G431RBT6, LCSC C431633. Accepted in ADR 0021, and drawn on the rotor sheet: direct Drive pins, BOR level 4, hardware IWDG with PR = /4 and RL = 799, option word 0xFBEEFCAA. The supervisor, the relay clamp, and the Drive STOP pin are off the sheet. A stuck Drive is the hardware IWDG. A physical emergency stop is the power switch or the AC feed.

1. A jog under the complete policy takes the stop path, because a jog has no target.
2. A command on a healthy link counts as a heartbeat. After `host_lost`, only HEARTBEAT or READ_STATUS clears the flag.
3. Dead-time floor of 500 ms, brake released through the reversal, and brake-release and brake-engage times (values TBD).
4. Drive independent-watchdog period. ADR 0021 sets PR = /4 and RL = 799, about 94 to 109 ms across the LSI range in DS12589 Table 44. The power-on reload stays 0xFFF, about 0.5 s, until firmware writes 799. That watchdog is the stuck-Drive response.
5. K1 rating. The relay stays. The G5LE-1A4 5 A inductive rating against about 7.3 A motor-plus-brake overlap is still open, as in DESIGN-NOTES.
6. Pot reference: the G4 VREFBUF (2.048 V, 2.5 V, or 2.95 V), or the separate filtered 3.3 V ADR 0018 left TBD. `drive_mcu` uses the filtered 3.3 V (R100, C106, C107) until that choice is closed.
7. Which sense interfaces get connector pins on the first board, beyond the dual-end pot.
8. Front-panel CW and CCW, if the headless panel of ADR 0006 is fitted: Drive inputs, so they become jog events while the Station is busy. A front-panel STOP, if fitted, is a Station input and sends the Drive protocol STOP. The Drive has no STOP pin.
9. Field update. ADR 0021 sets nSWBOOT0 = 0. Field update is a command the running Drive accepts, or SWD. Still open: the `ENTER_BOOTLOADER` magic, and whether a later change restores pin boot. The bootloader pin list in AN2606 Table 115 stays forbidden for gates either way.
10. The CCW hold network is gone, along with U2 and the direction gates, and this edit removes the remaining AND gates U3, U6, U9, and U10. A repair of the discrete hold would be a different change.
11. D2, the SMAJ90CA, pending the owner's push. Section 6 still records the discrepancy already in this tree: DESIGN-NOTES says `AC_BUS`; the 2026-10-17 netlist has pin 2 on `AC_FUSED`. The local schematic, not yet pushed, places D2 after the fuse and before the relay. This tree is not edited to match until that push.
12. TR1 rating. The transformer stays on `rotor_drive`. Still open: the 5 A rating versus about 7.3 A motor-plus-brake, and saturation.
13. Heading unit of 0.01° and speed in permille.
14. Drive flash stores park, limits, calibration, ramps, and deadlines. The preset catalog and the parking schedules stay on the Station.
15. Duty-cycle rest (the CDE 10% and Yaesu three-minute notes in the system overview). This machine enforces max run as `RUN_TIMEOUT` and leaves a minimum off time out until a preset needs it.

## Developer

These commands regenerate the figure and run the host tests this plan extends. They are for development. The running controller does not need them.

Regenerate the state diagram:

```bash
dot -Tpng -Gdpi=150 -o docs/design/img/drive-controller-fsm.png docs/design/img/src/drive-controller-fsm.dot
```

Host tests for `software/firmware` (the axis-machine rows are not in the tree yet; this is the build they will join):

```bash
cmake -S software/firmware -B software/firmware/build
cmake --build software/firmware/build
ctest --test-dir software/firmware/build --output-on-failure
```

Physics tests already in the simulator tree:

```bash
make -C software/sim test
```
