wa1hco/rotator_controller/docs/decisions/0006-headless-panel.md

# ADR 0006: Headless, with a minimal front panel

- Status: Accepted
- Date: 2026-10-11
- Revised: 2026-10-12. The host interface named below is ADR 0015.
- Revised: 2026-10-18, with ADR 0021. A front-panel STOP, if this panel is fitted, is a Station input. It sends the Drive protocol STOP. The Drive sheet has no STOP pin. Removing power is the user's power switch or the AC feed.

## Context

The system overview treats the display as a module that can grow, and
lists a numeric display as a possible default. For this controller the
choice is narrower: the box is operated from a PC or over Ethernet.

## Decision

The controller is headless. There is no LCD, OLED, or knob. The front
panel has STOP, CW, and CCW, plus status LEDs. Heading, calibration, and
setup are done from the host: the Ethernet web UI first, and the same
commands on the USB and TCP console (ADR 0015). BOOT and RESET are not
front-panel controls.

## Consequences

Protocol handling and a host UI matter more than a menu system. The
front-panel buttons are direct motion inputs, with STOP highest priority.
A display can be added later as a front end. It is not in the baseline
enclosure.
