wa1hco/rotator_controller/docs/design/img/analog-input.png

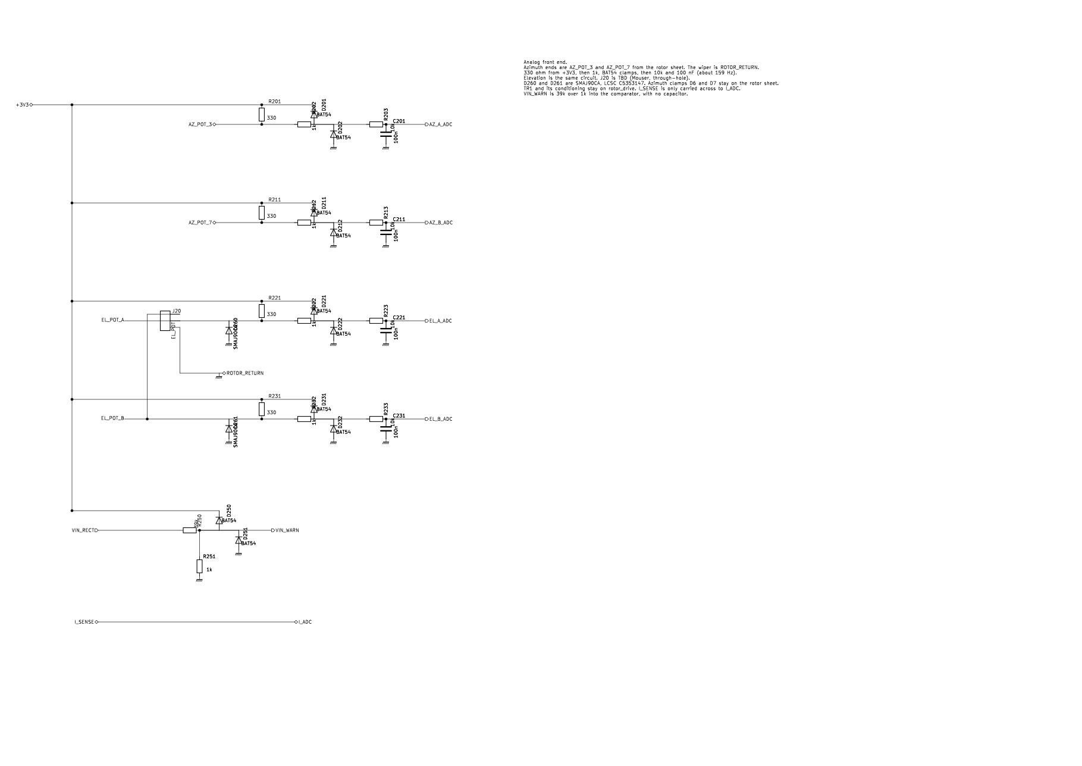
docs/design/img/analog-input.png
