wa1hco/rotator_controller/docs/design/img/rotor-drive-supervisor-after.png

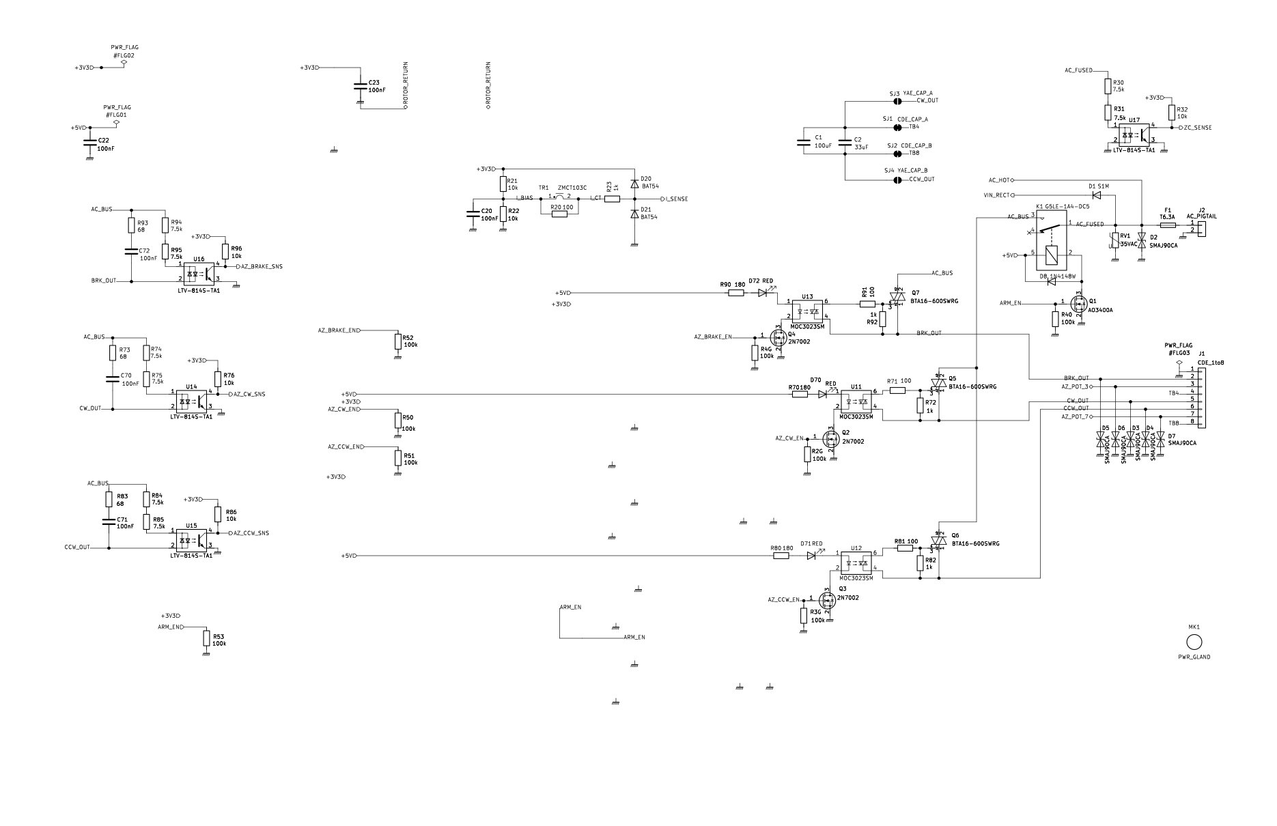
docs/design/img/rotor-drive-supervisor-after.png
