wa1hco/rotator_controller/docs/design/img/rotor-drive-supervisor-before.png

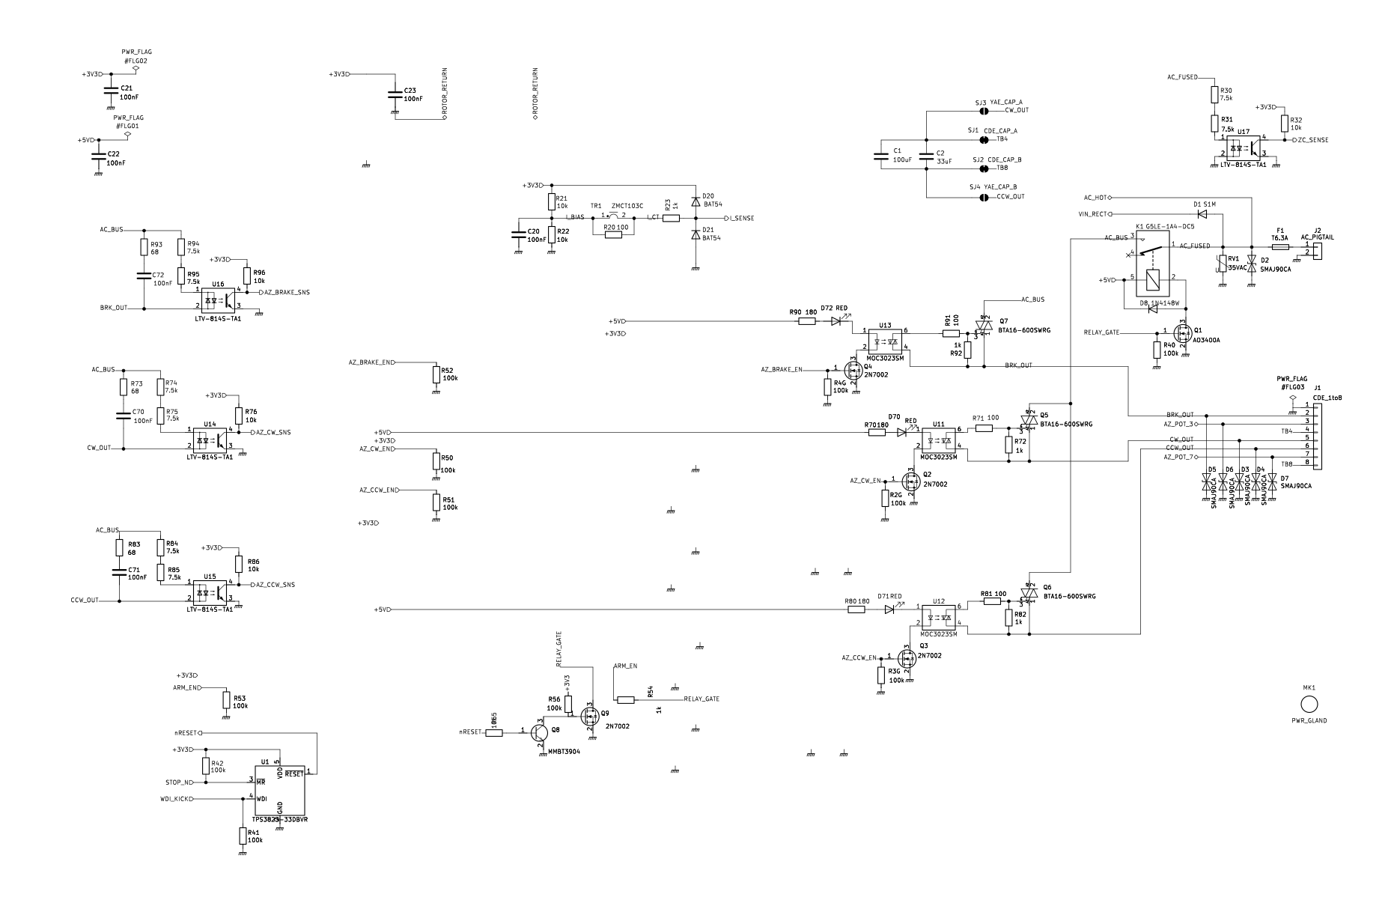
docs/design/img/rotor-drive-supervisor-before.png
