wa1hco/rotator_controller/docs/design/img/rotor-drive-tidy-after.png

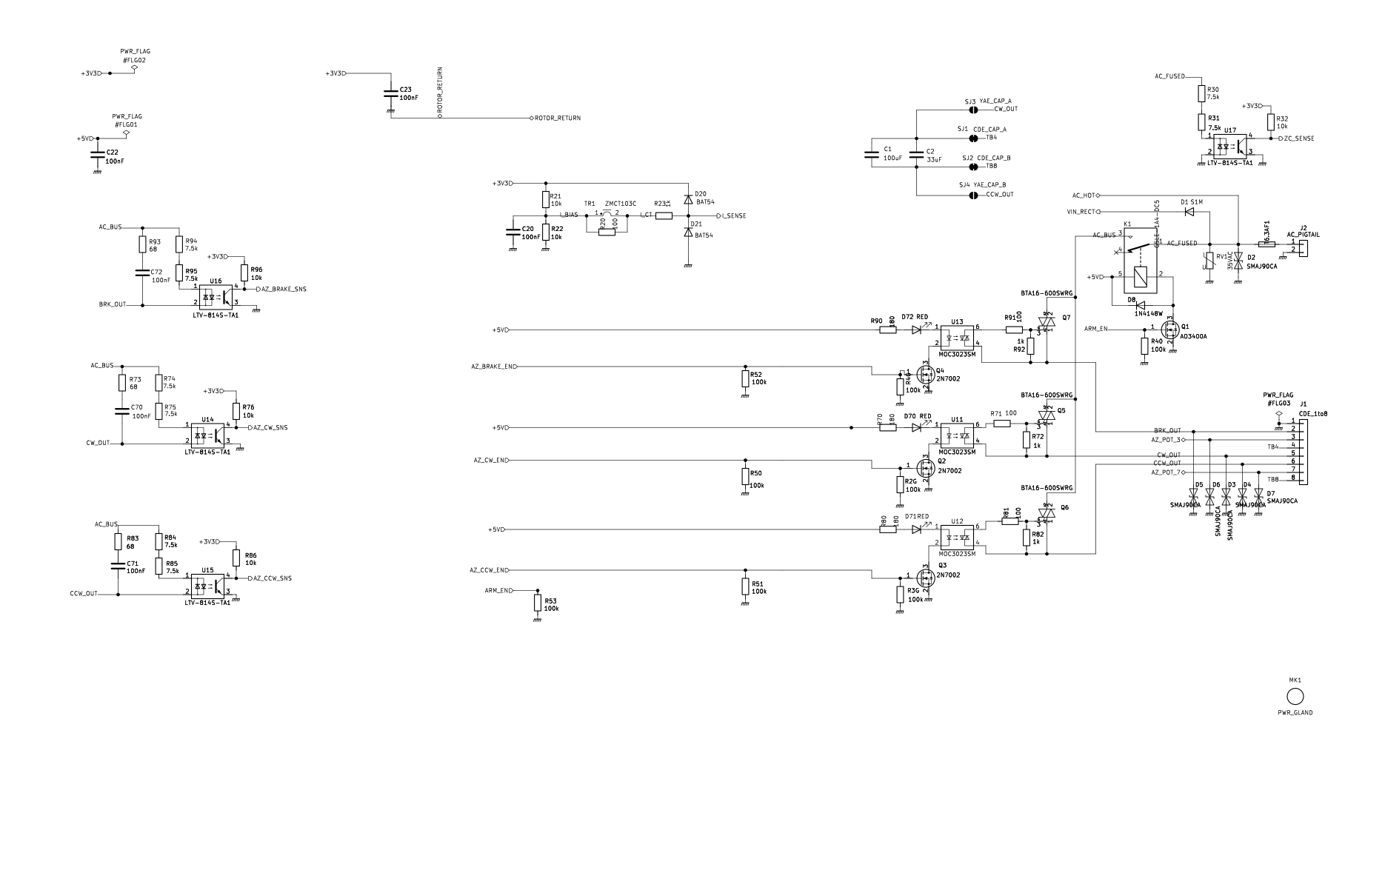
docs/design/img/rotor-drive-tidy-after.png
