wa1hco/rotator_controller/docs/design/img/triac-side-view.png

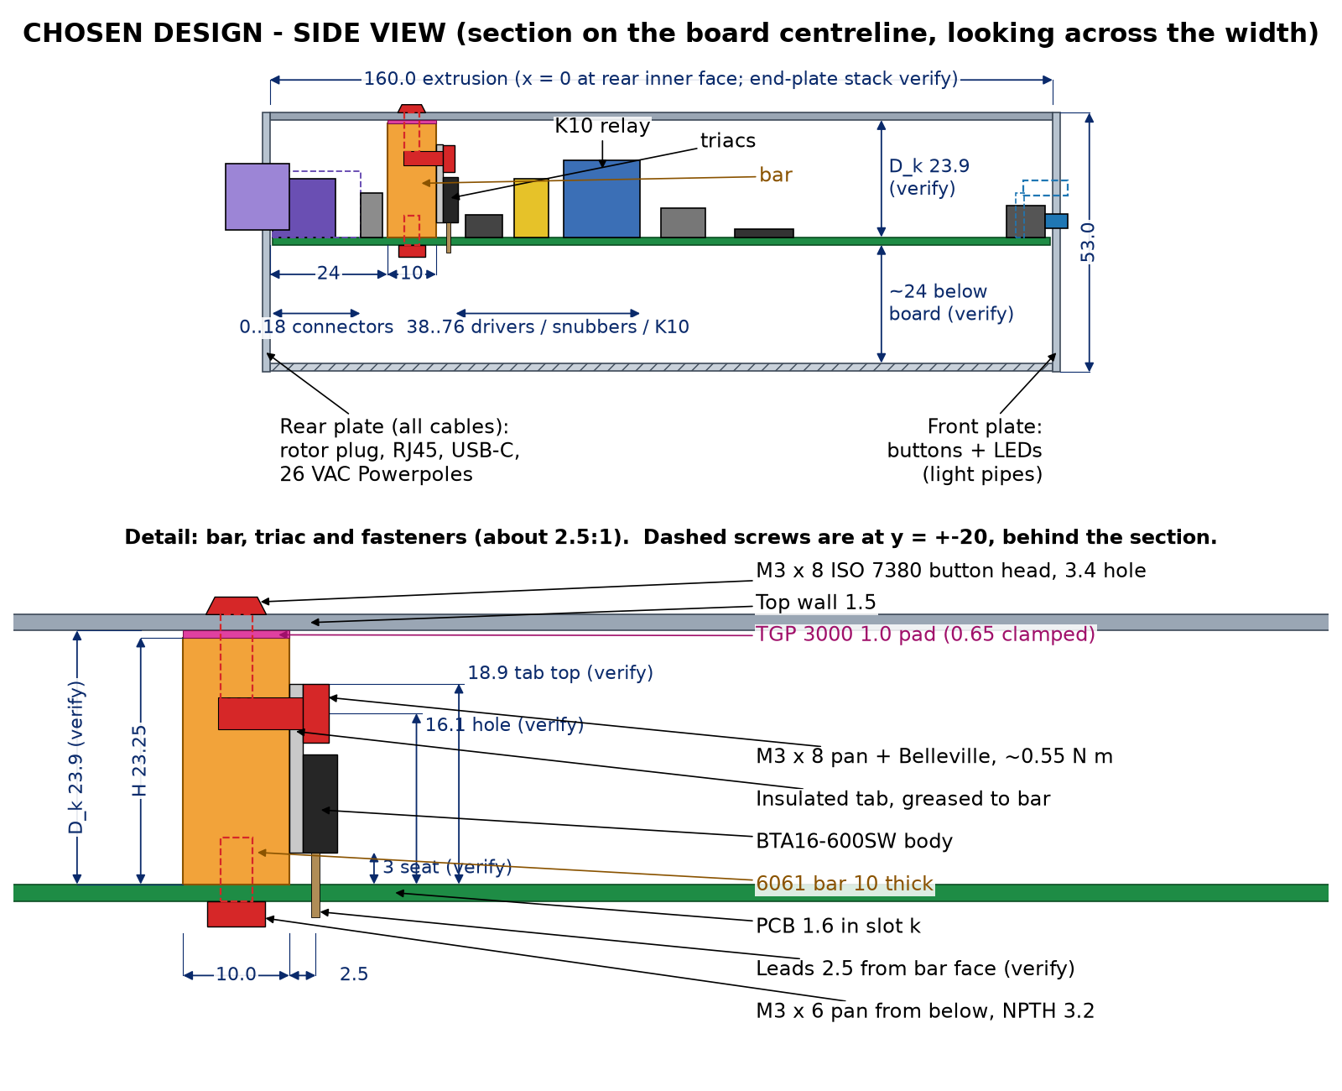
docs/design/img/triac-side-view.png
