wa1hco/rotator_controller/docs/design/img/triac-top-view.png

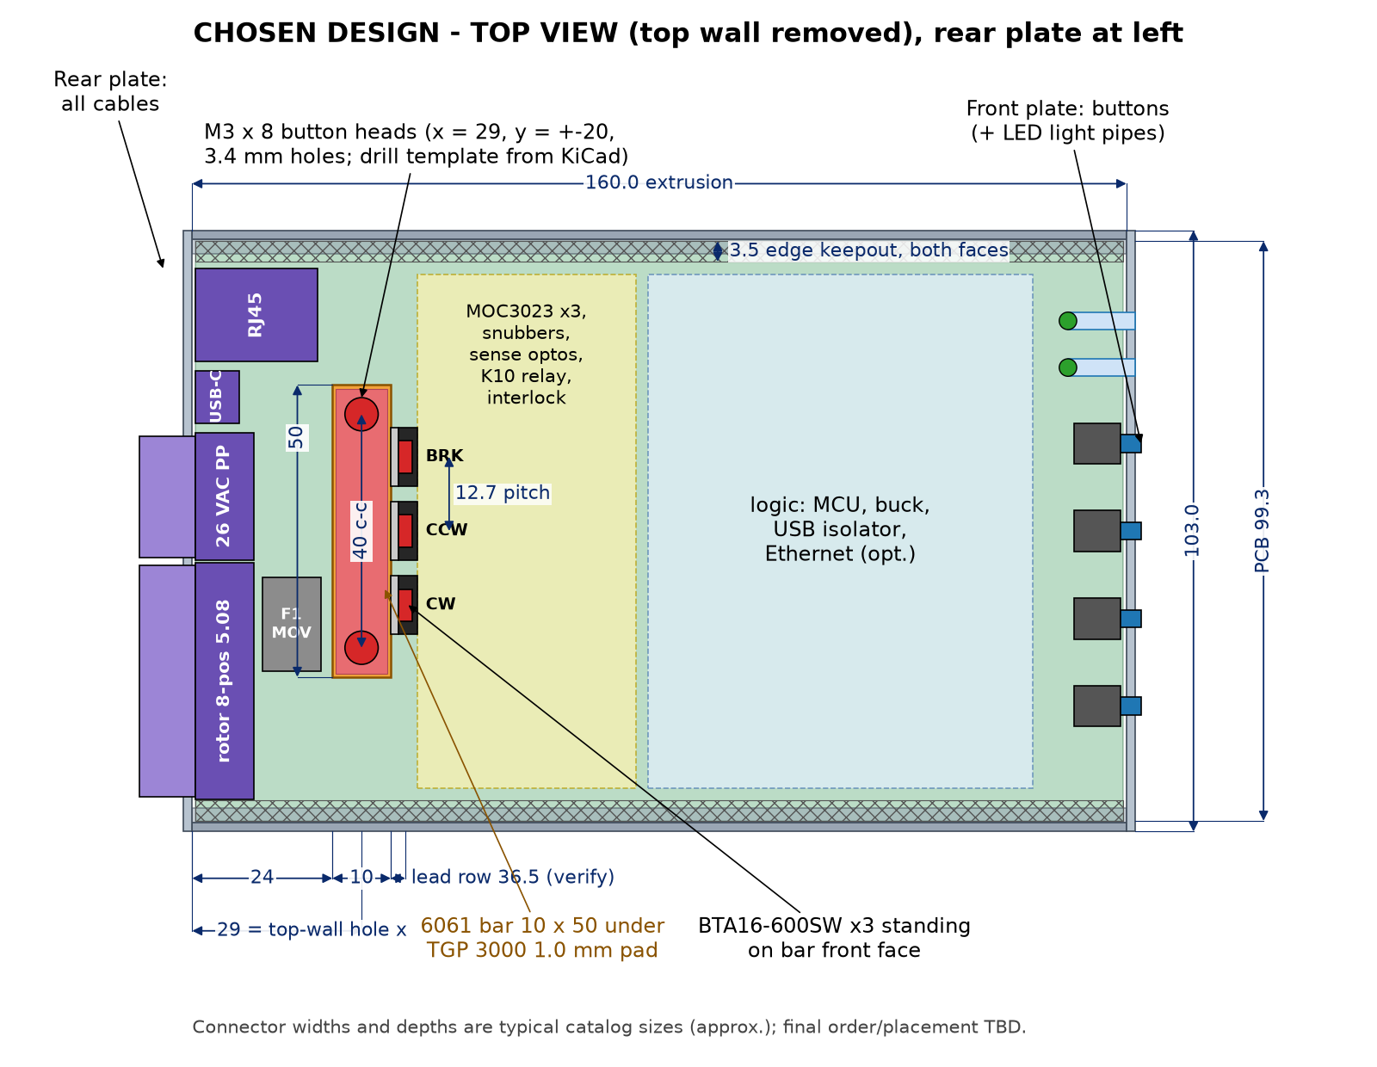
docs/design/img/triac-top-view.png
