wa1hco/rotator_controller/hardware/controller-f407/docs/schematic-text/after-controller-f407.png

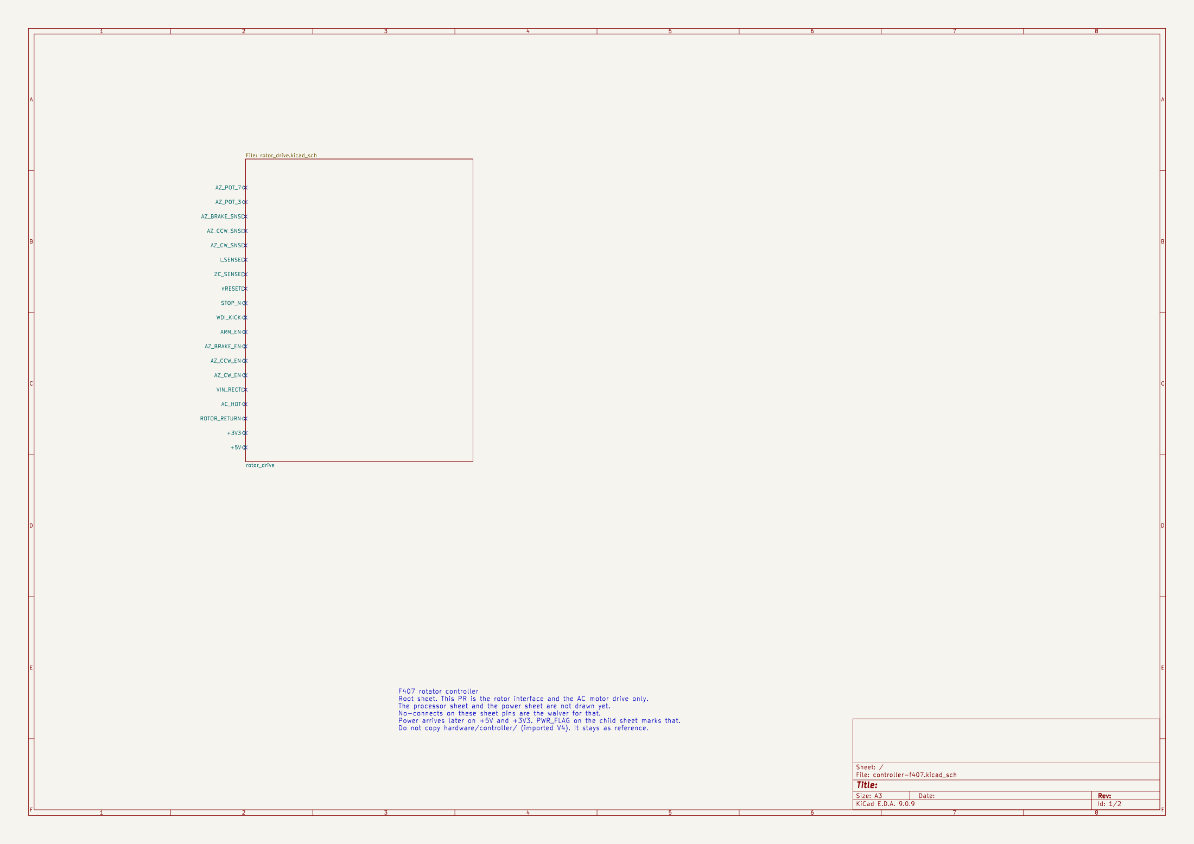
hardware/controller-f407/docs/schematic-text/after-controller-f407.png
