wa1hco/rotator_controller/hardware/controller-f407/docs/schematic-text/after-rotor_drive-offpage.png

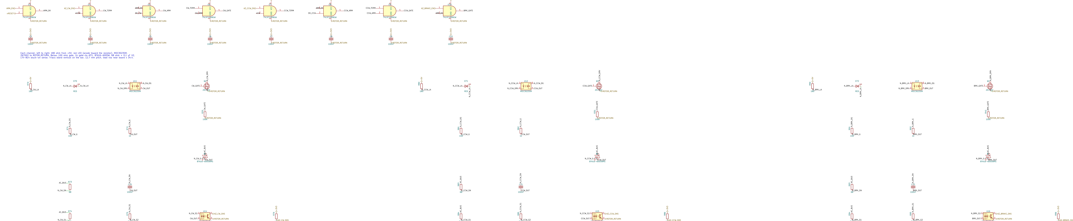
hardware/controller-f407/docs/schematic-text/after-rotor_drive-offpage.png
