wa1hco/rotator_controller/hardware/controller-f407/docs/schematic-text/before-rotor_drive-full.png

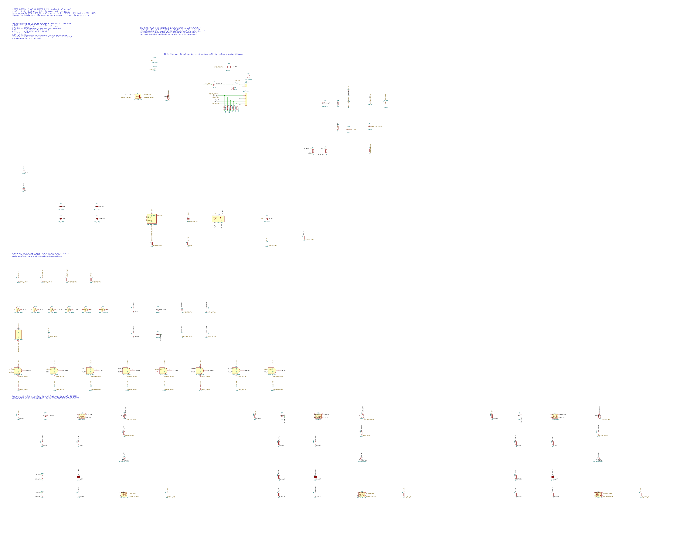
hardware/controller-f407/docs/schematic-text/before-rotor_drive-full.png
