wa1hco/rotator_controller/hardware/controller-f407/docs/schematic-text/before-rotor_drive-j1.png

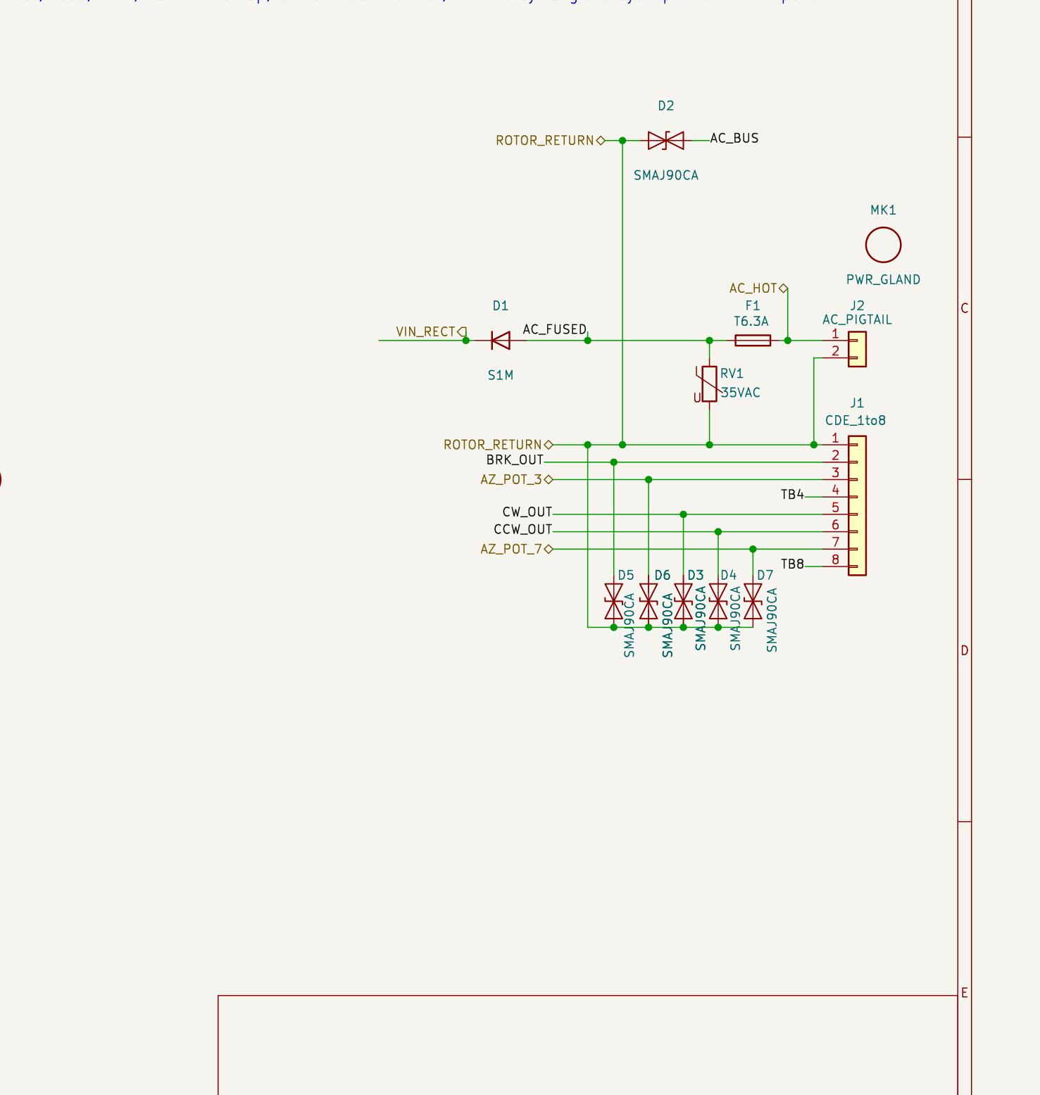
hardware/controller-f407/docs/schematic-text/before-rotor_drive-j1.png
