wa1hco/rotator_controller/hardware/controller/mechanical/outline-1455N1601/outline.png

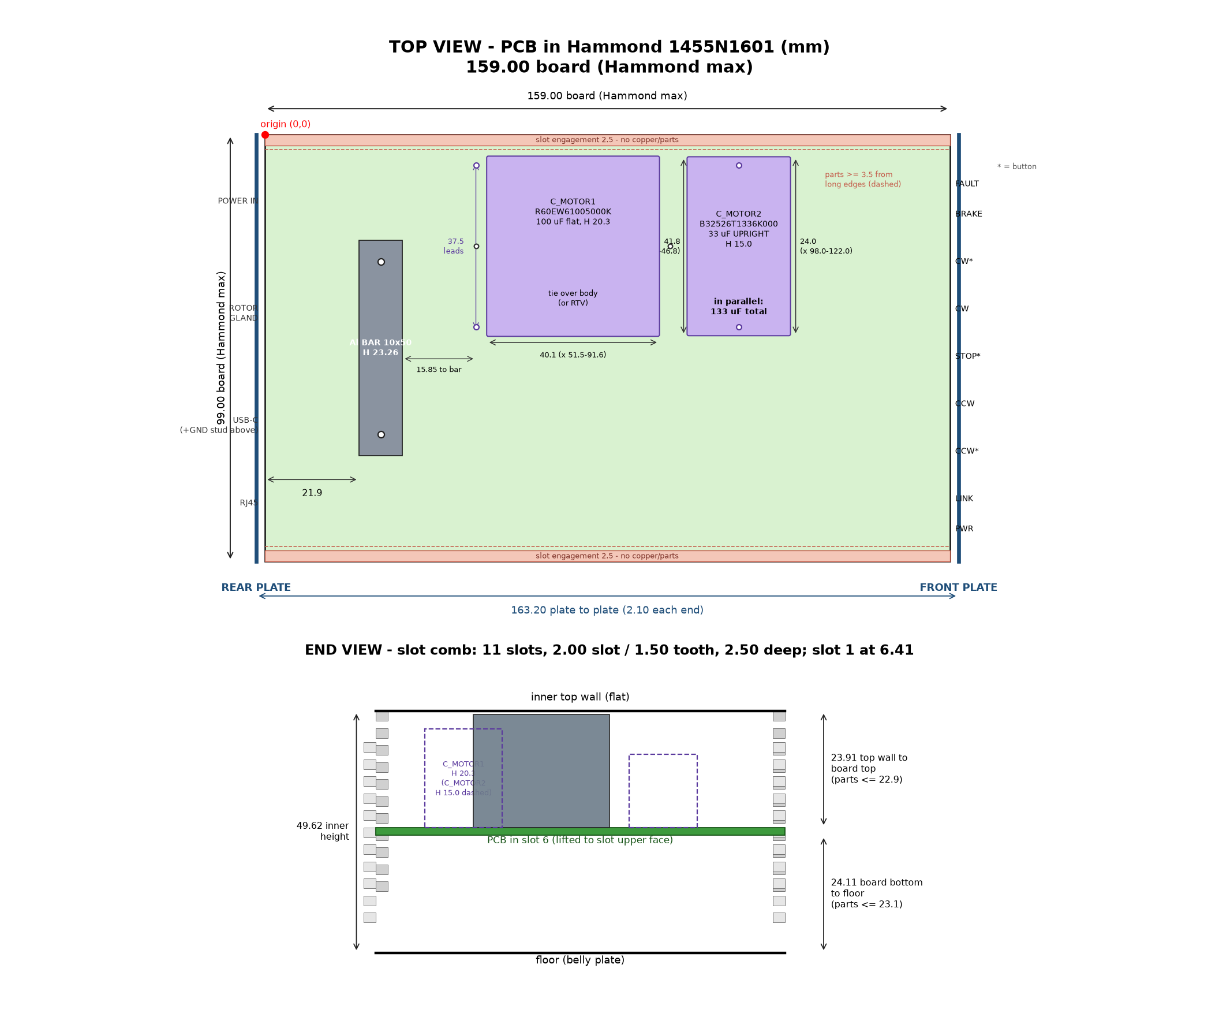
hardware/controller/mechanical/outline-1455N1601/outline.png
