wa1hco/rotator_controller/hardware/controller/mechanical/panels/rear-panel-1455N1601.png

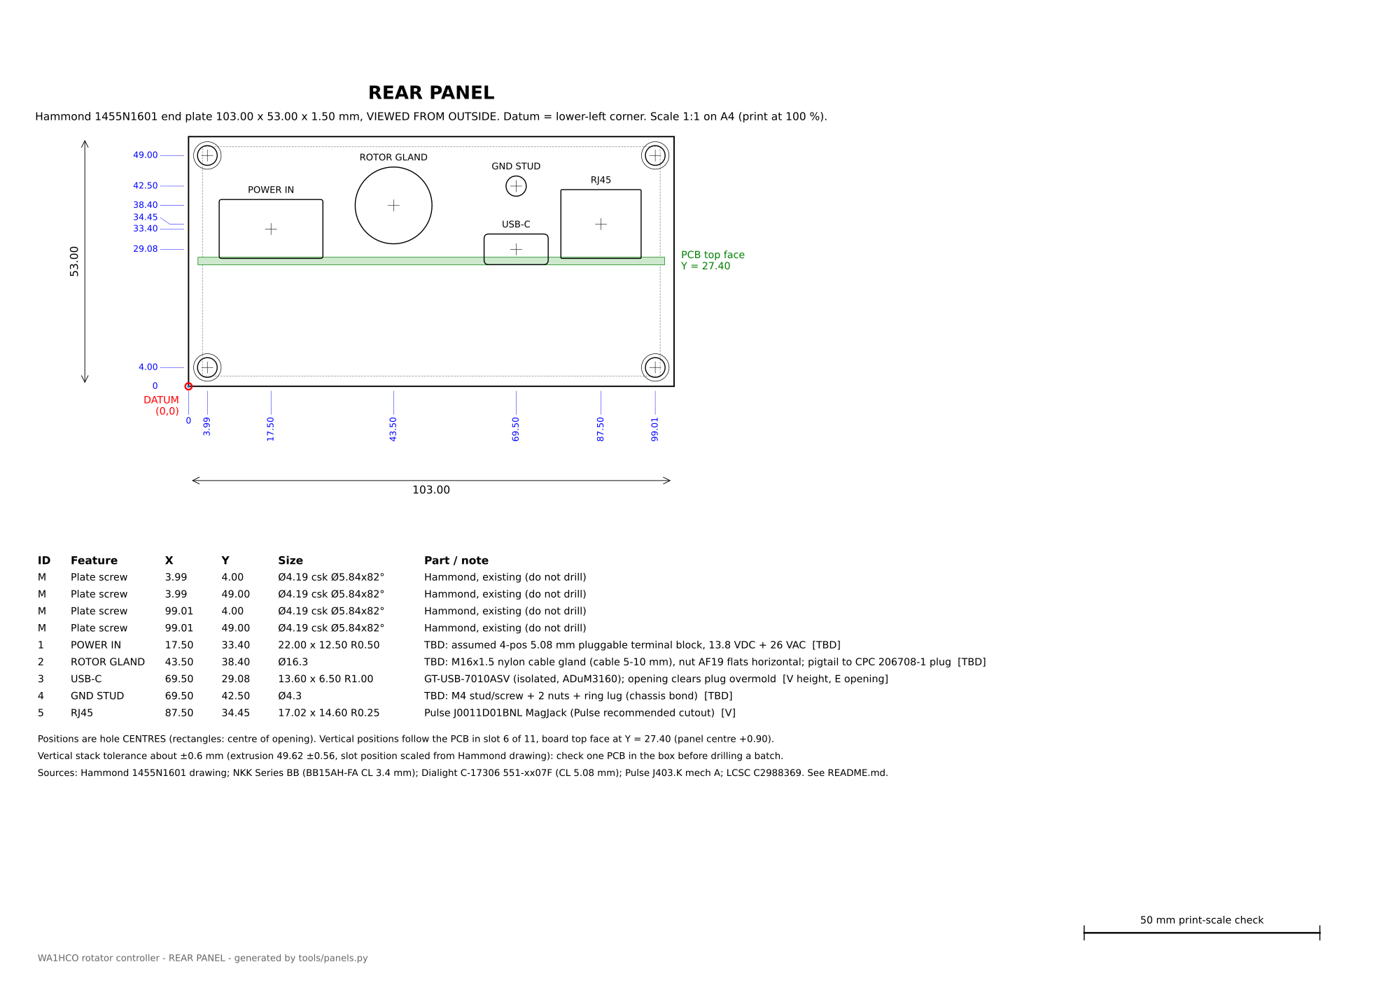
hardware/controller/mechanical/panels/rear-panel-1455N1601.png
