wa1hco/rotator_controller/hardware/controller-f407/controller-f407.kicad_pcb

## KiCad design hardware/controller-f407/controller-f407.kicad_pcb (2026-10-21)

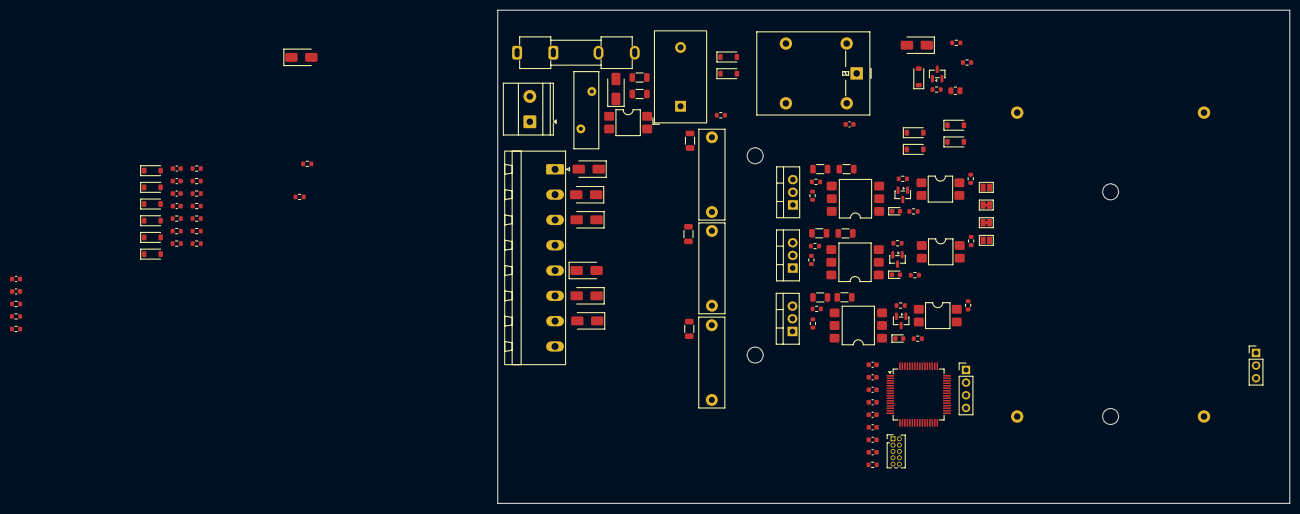
[picture p16: board controller-f407.kicad_pcb from above]

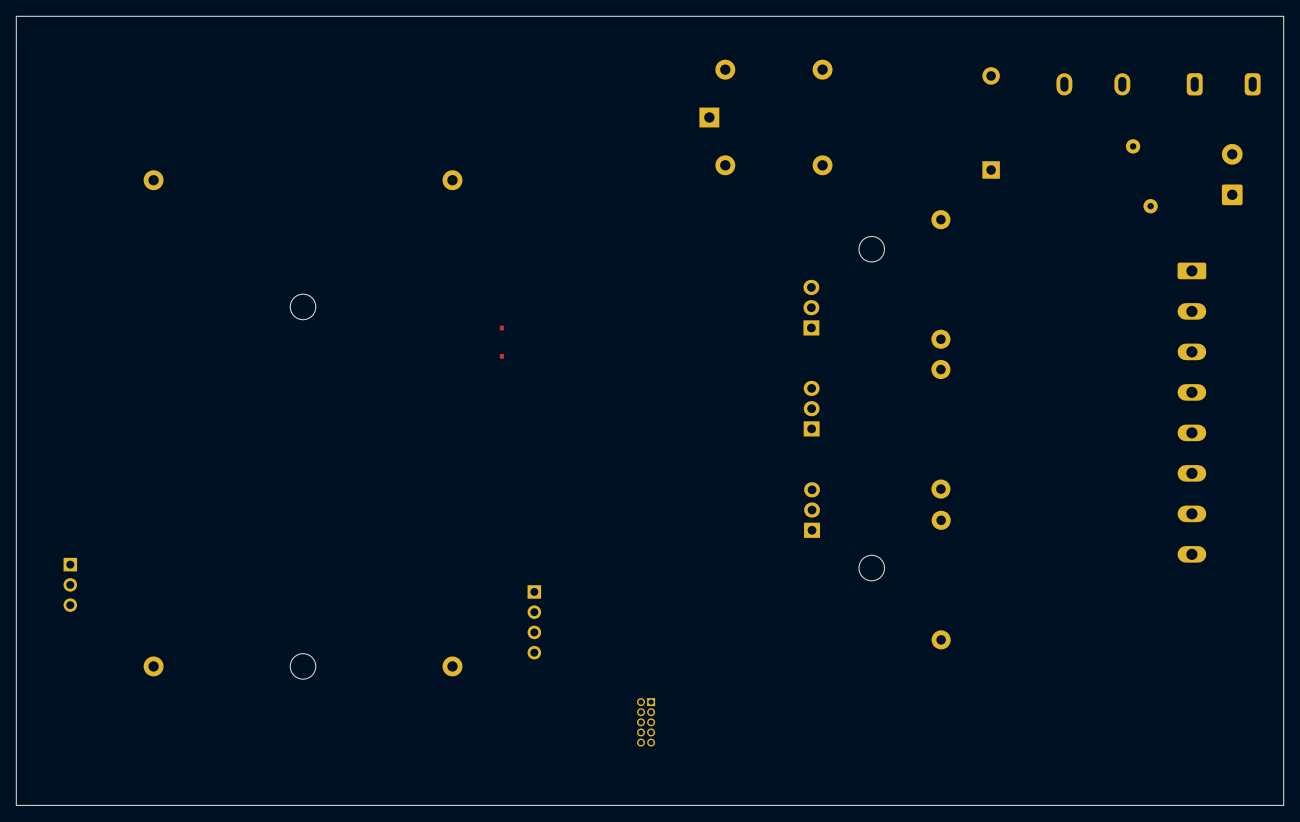
[picture p17: board controller-f407.kicad_pcb from below]

Board: 2 copper layers, 159.0 x 99.0 mm, 122 parts (2 on the bottom side), 72 nets, no tracks yet.

Parts:
C1, C2, C3: 100nF; C_0603_1608Metric
C4, C5, C8: 100nF; C_Rect_L18.0mm_W5.0mm_P15.00mm_FKS3_FKP3
C6: 100uF; C_Rect_KEMET_R60_P37.5_L41.5_W20_H40_Flat
C7: 33uF; C_Rect_TDK_B32526T_P37.5_L41.5_W24_H15_Upright
C9, C11, C12, C13, C14, C16, C17, C18, C19, C20: 100n; C_0603_1608Metric
C10: 1u; C_0603_1608Metric
C15: 4.7u; C_0603_1608Metric
D1, D2, D14, D15, D16, D17, D18, D20, D21, D23, D24, D25: BAT54; D_SOD-123
D3: S1M; D_SMA
D4, D8, D9, D10, D11, D12, D19, D22: SMAJ90CA; D_SMA
D5: 1N4148W; D_SOD-123
D6, D7, D13: RED; LED_0603_1608Metric
F1: T6.3A; Fuseholder_Clip-5x20mm_Keystone_3512_Inline_P23.62x7.27mm_D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
HS1: AL_BAR_10x50 + 2x NPTH 3.2; AL_BAR_10x50
J1: AC_PIGTAIL; TerminalBlock_Phoenix_MKDS-1,5-2-5.08_1x02_P5.08mm_Horizont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
J2: CDE_1to8; PhoenixContact_MSTBA_2,5_8-G-5,08_1x08_P5.08mm_Horizontal
J3: SWD; PinHeader_2x05_P1.27mm_Vertical
J4: UART; PinHeader_1x04_P2.54mm_Vertical
J5: EL_POT; PinHeader_1x03_P2.54mm_Vertical
K1: G5LE-1A4-DC5; Relay_SPDT_Omron-G5LE-1
MK1: PWR_GLAND; Panel_Gland_M16
Q1: AO3400A; SOT-23
Q2, Q4, Q6: BTA16-600SWRG; TO-220-3_Vertical
Q3, Q5, Q7: 2N7002; SOT-23
R1, R4, R5, R15, R22, R29, R33, R36, R39, R42: 10k; R_0603_1608Metric
R2, R11, R18, R25, R32, R35, R38, R41, R44: 1k; R_0603_1608Metric
R2G1, R3G1, R4G1, R8: 100k; R_0603_1608Metric
R3: 100; R_0805_2012Metric
R6, R7, R12, R14, R19, R21, R26, R28: 7.5k; R_1206_3216Metric
R9, R16, R23: 100; R_0603_1608Metric
R10, R17, R24: 180; R_0603_1608Metric
R13, R20, R27: 68; R_1206_3216Metric
R30: 10; R_0603_1608Metric
R31, R34, R37, R40: 330; R_0603_1608Metric
R43: 39k; R_0603_1608Metric
RV1: 35VAC; RV_Disc_D15.5mm_W5mm_P7.5mm
SJ1: YAE_CAP_A; SolderJumper-2_P1.3mm_Open_Pad1.0x1.5mm
SJ2: CDE_CAP_A; SolderJumper-2_P1.3mm_Bridged_Pad1.0x1.5mm
SJ3: CDE_CAP_B; SolderJumper-2_P1.3mm_Bridged_Pad1.0x1.5mm
SJ4: YAE_CAP_B; SolderJumper-2_P1.3mm_Open_Pad1.0x1.5mm
TR1: ZMCT103C; Transformer_Zeming_ZMCT103C
U1, U3, U5, U7: LTV-814S-TA1; SMDIP-4_W7.62mm
U2, U4, U6: MOC3023SM; SMDIP-6_W9.53mm
U8: STM32G431RBTx; LQFP-64_10x10mm_P0.5mm

Connections:
/+3V3: C3.1, C11.1, C12.1, C13.1, C14.1, C15.1, D1.1 (K), D14.1 (K), D16.1 (K), D18.1 (K), D21.1 (K), D24.1 (K), J3.1, J4.2, R1.1, R5.1, R15.1, R22.1, R29.1, R30.2, R31.1, R34.1, R37.1, R40.1, U8.1 (VBAT), U8.16 (VDD), U8.32 (VDD), U8.48 (VDD), U8.64 (VDD)
/ARM_EN: Q1.1 (G), R8.1, U8.55 (PD2)
/AZ_A_ADC: C17.1, R33.2, U8.8 (PC0)
/AZ_BRAKE_EN: Q3.1 (G), R4G1.1, U8.54 (PC12)
/AZ_BRAKE_SNS: R15.2, U3.4, U8.4 (PC15)
/AZ_B_ADC: C18.1, R36.2, U8.9 (PC1)
/AZ_CCW_EN: Q7.1 (G), R3G1.1, U8.39 (PC7)
/AZ_CCW_SNS: R29.2, U7.4, U8.3 (PC14)
/AZ_CW_EN: Q5.1 (G), R2G1.1, U8.38 (PC6)
/AZ_CW_SNS: R22.2, U5.4, U8.2 (PC13)
/AZ_POT_3: D9.2 (A2), J2.3, R31.2, R32.1
/AZ_POT_7: D12.2 (A2), J2.7, R34.2, R35.1
/EL_A_ADC: C19.1, R39.2, U8.10 (PC2)
/EL_B_ADC: C20.1, R42.2, U8.11 (PC3)
/I_ADC: D1.2 (A), D2.1 (K), R2.2, U8.12 (PA0)
/VIN_RECT: D3.1 (K), R43.1
/VIN_WARN: D24.2 (A), D25.1 (K), R43.2, R44.1, U8.13 (PA1)
/ZC_SENSE: R5.2, U1.4, U8.58 (PB5)
/analog_input/EL_POT_A: D19.1 (K), J5.2, R37.2, R38.1
/analog_input/EL_POT_B: D22.1 (K), J5.3, R40.2, R41.1
/rotor_drive/+5V: C2.1, D5.1 (K), K1.5, R10.1, R17.1, R24.1
/rotor_drive/AC_BUS: K1.3, Q2.2 (A2), Q4.2 (A2), Q6.2 (A2), R12.1, R13.1, R19.1, R20.1, R26.1, R27.1
/rotor_drive/AC_FUSED: D3.2 (A), D4.2 (A2), F1.2, K1.1, R7.1, RV1.1
/rotor_drive/BRK_OUT: C4.2, D8.2 (A2), J2.2, Q2.1 (A1), R11.2, U2.4, U3.2
/rotor_drive/CCW_OUT: C8.2, D11.2 (A2), J2.6, Q6.1 (A1), R25.2, SJ4.2 (B), U6.4, U7.2
/rotor_drive/CW_OUT: C5.2, D10.2 (A2), J2.5, Q4.1 (A1), R18.2, SJ1.2 (B), U4.4, U5.2
/rotor_drive/I_BIAS: C1.1, R1.2, R3.2, R4.1, TR1.1
/rotor_drive/I_CT: R2.1, R3.1, TR1.2
/rotor_drive/TB4: J2.4, SJ2.2 (B)
/rotor_drive/TB8: J2.8, SJ3.2 (B)
GNDPWR: C1.2, C2.2, C3.2, C9.2, C10.2, C11.2, C12.2, C13.2, C14.2, C15.2, C16.2, C17.2, C18.2, C19.2, C20.2, D2.2 (A), D4.1 (A1), D8.1 (A1), D9.1 (A1), D10.1 (A1), D11.1 (A1), D12.1 (A1), D15.2 (A), D17.2 (A), D19.2 (A), D20.2 (A), D22.2 (A), D23.2 (A), D25.2 (A), J1.2, J2.1, J3.3, J3.5, J3.9, J4.1, J5.1, Q1.2 (S), Q3.2 (S), Q5.2 (S), Q7.2 (S), R2G1.2, R3G1.2, R4.2, R4G1.2, R8.2, R44.2, RV1.2, U1.2, U1.3, U3.3, U5.3, U7.3, U8.15 (VSS), U8.27 (VSSA), U8.31 (VSS), U8.47 (VSS), U8.63 (VSS)
unnamed: C4.1, R13.2
unnamed: C5.1, R20.2
unnamed: C8.1, R27.2
unnamed: D5.2 (A), K1.2, Q1.3 (D)
unnamed: D6.2 (A), R10.2
unnamed: D6.1 (K), U2.1
unnamed: D7.2 (A), R17.2
unnamed: D7.1 (K), U4.1
unnamed: D13.2 (A), R24.2
unnamed: D13.1 (K), U6.1
unnamed: D14.2 (A), D15.1 (K), R32.2, R33.1
unnamed: D16.2 (A), D17.1 (K), R35.2, R36.1
unnamed: D18.2 (A), D20.1 (K), R38.2, R39.1
unnamed: D21.2 (A), D23.1 (K), R41.2, R42.1
unnamed: F1.1, J1.1
unnamed: Q2.3 (G), R9.2, R11.1
unnamed: Q3.3 (D), U2.2
unnamed: Q4.3 (G), R16.2, R18.1
unnamed: Q5.3 (D), U4.2
unnamed: Q6.3 (G), R23.2, R25.1
unnamed: Q7.3 (D), U6.2
unnamed: R6.1, R7.2
unnamed: R6.2, U1.1
unnamed: R9.1, U2.6
unnamed: R12.2, R14.1
unnamed: R14.2, U3.1
unnamed: R16.1, U4.6
unnamed: R19.2, R21.1
unnamed: R21.2, U5.1
unnamed: R23.1, U6.6
unnamed: R26.2, R28.1
unnamed: R28.2, U7.1
unnamed: C6.1, C7.1, SJ1.1 (A), SJ2.1 (A)
unnamed: C6.2, C7.2, SJ3.1 (A), SJ4.1 (A)
unnamed: J3.2, U8.49 (PA13)
unnamed: J3.4, U8.50 (PA14)
unnamed: J3.6, U8.56 (PB3)
unnamed: J4.3, U8.30 (PB10)
unnamed: J4.4, U8.33 (PB11)
unnamed: C16.1, J3.10, U8.7 (PG10)
unnamed: C9.1, C10.1, R30.1, U8.28 (VREF+), U8.29 (VDDA)
