wa1hco/rotator_controller/hardware/controller/Rotator-Controller-V4.kicad_pcb

## KiCad design hardware/controller/Rotator-Controller-V4.kicad_pcb (2026-10-11)

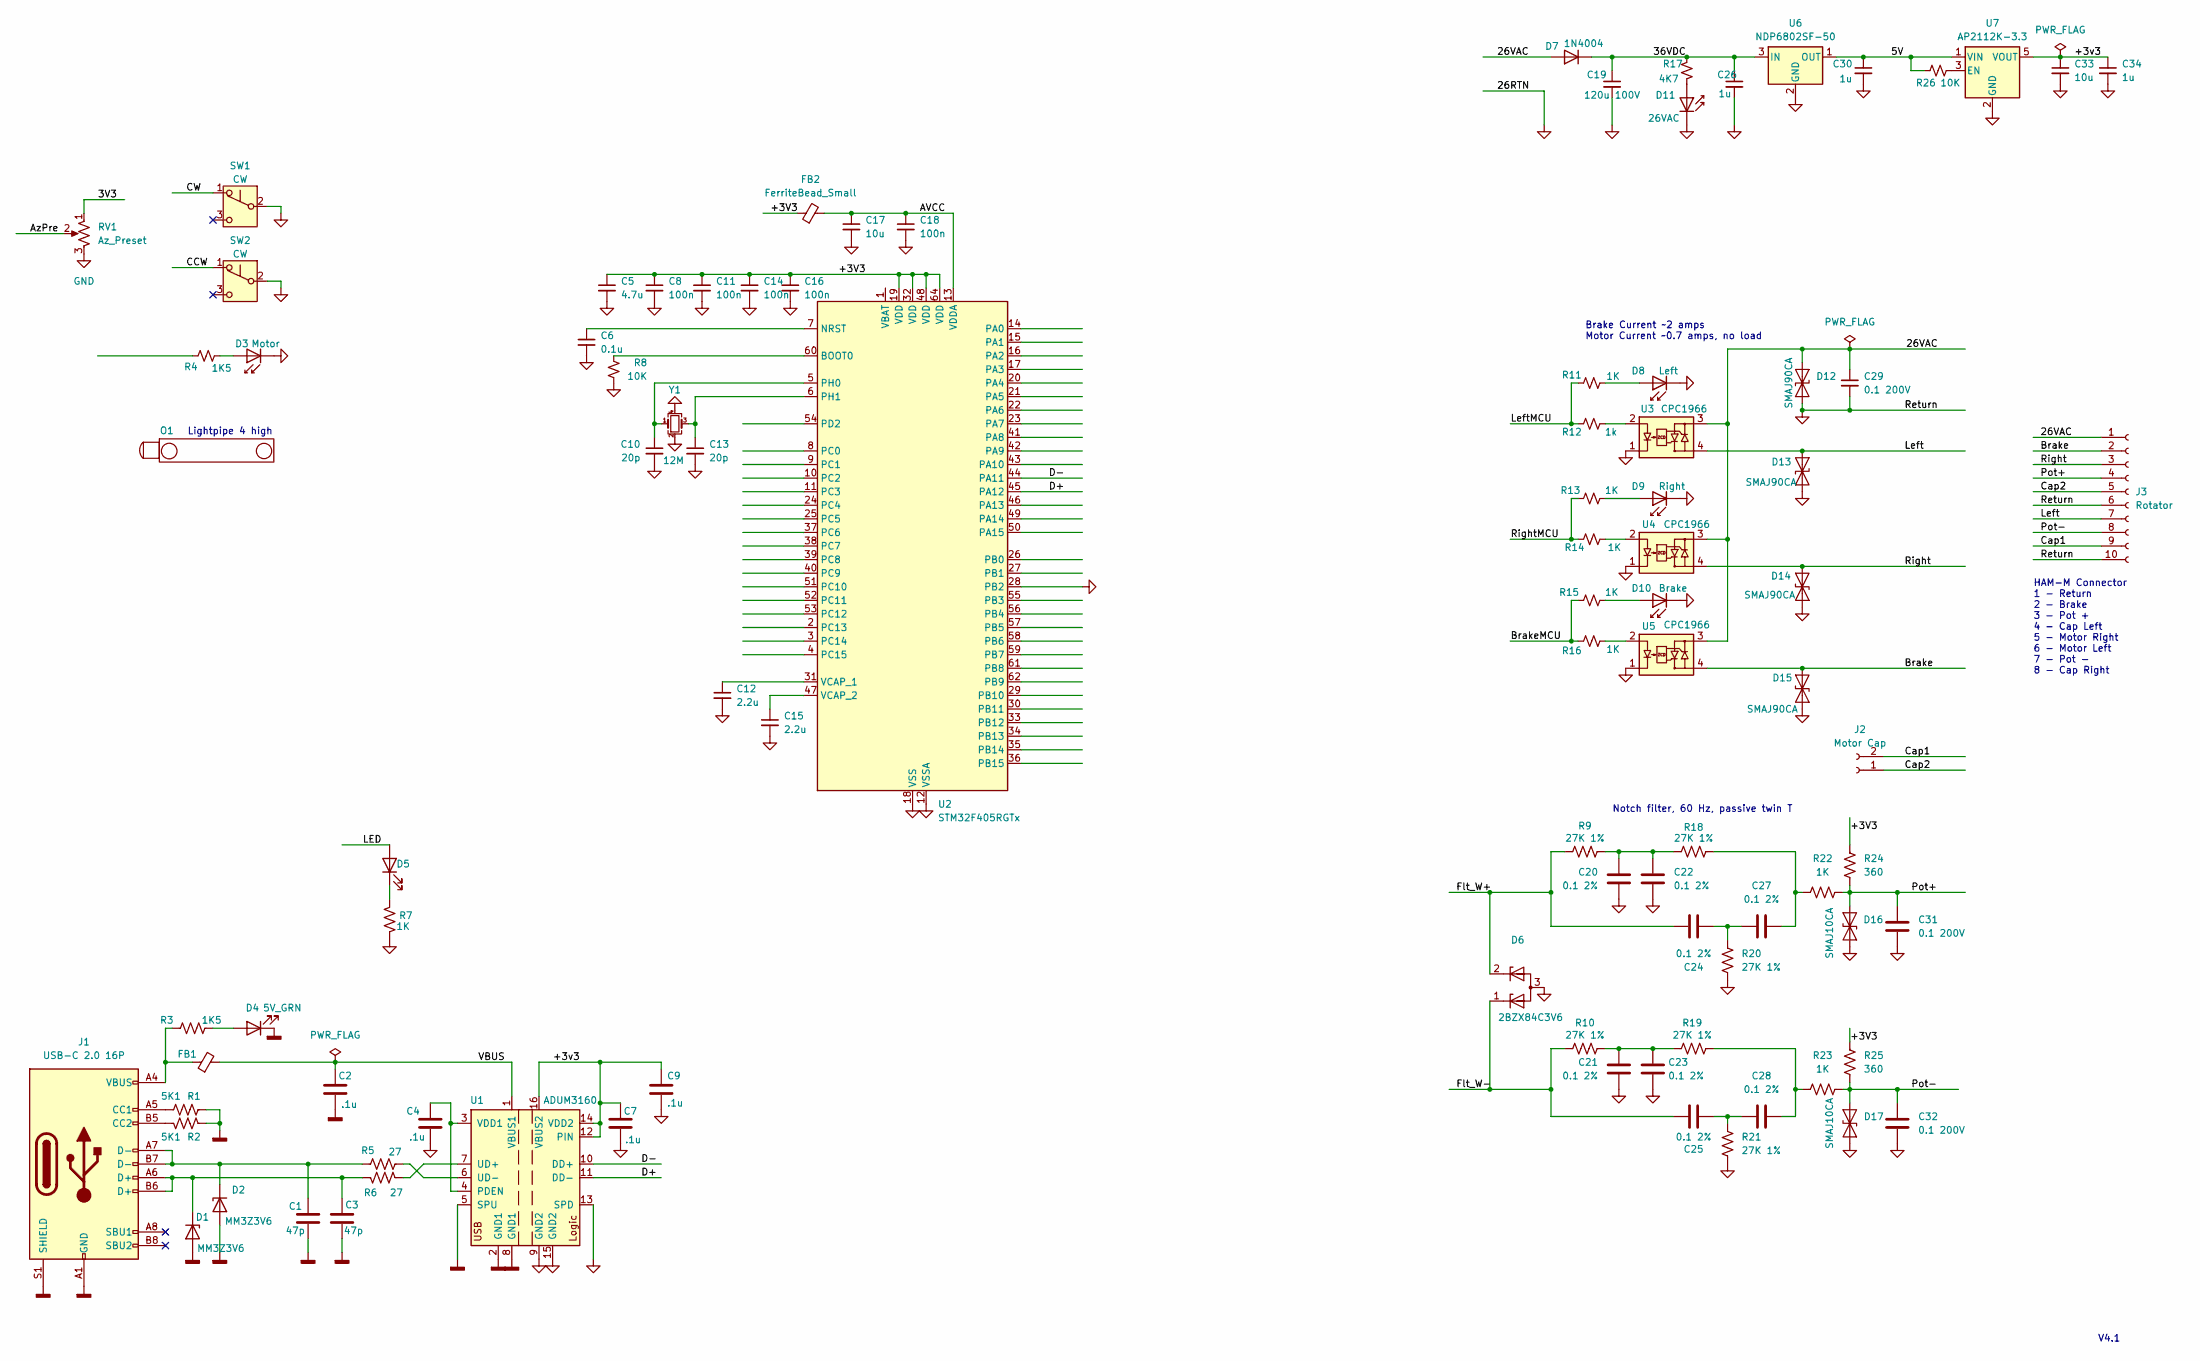
[picture p18: schematic Rotator-Controller-V4.kicad_sch]

Parts:
C1, C3: 47p; C_0603_1608Metric; LCSC C1671
C2, C4, C7, C9: .1u; C_0603_1608Metric; LCSC C14663
C5: 4.7u; C_0603_1608Metric
C6: 0.1u; C_0603_1608Metric
C8, C11, C14, C16, C18: 100n; C_0603_1608Metric
C10, C13: 20p; C_0603_1608Metric
C12, C15: 2.2u; C_0603_1608Metric
C17, C33: 10u; C_0603_1608Metric
C19: 120u 100V; CP_Elec_8x10
C20: 0.1 2%; C_1206_3216Metric_Pad1.33x1.80mm_HandSolder; LCSC C6478705
C21, C22, C23, C24, C25, C27, C28: 0.1 2%; C_1206_3216Metric_Pad1.33x1.80mm_HandSolder
C26, C30: 1u; C_1206_3216Metric_Pad1.33x1.80mm_HandSolder
C29, C31, C32: 0.1 200V; C_1206_3216Metric_Pad1.33x1.80mm_HandSolder
C34: 1u; C_0603_1608Metric
D1, D2: MM3Z3V6; D_SOD-323; LCSC C116949
D3: Motor; LED_0402_1005Metric
D4: 5V_GRN; LED_0402_1005Metric; LCSC C965804
D5: White; LED_0402_1005Metric; LCSC C965804
D6: 2BZX84C3V6; SOT-23
D7: 1N4004; D_SOD-123F
D8: Left; LED_0402_1005Metric
D9: Right; LED_0402_1005Metric
D10: Brake; LED_0402_1005Metric
D11: 26VAC; LED_0402_1005Metric
D12, D13, D14, D15: SMAJ90CA; D_SMA
D16, D17: SMAJ10CA; D_SMA
FB1: FerriteBead_Small; L_0805_2012Metric; LCSC C1017
FB2: FerriteBead_Small; L_0805_2012Metric
J1: USB-C 2.0 16P; USB_C_Receptacle_G-Switch_GT-USB-7010ASV; LCSC C2988369
J2: Motor Cap; PinHeader_1x02_P2.54mm_Vertical
J3: Rotator; TE_MATE-N-LOK_1-770971-x_2x05_P4.14mm_Horizontal
O1: LP4-EP
R1, R2: 5K1; R_0603_1608Metric; LCSC C23186
R3: 1K5; R_0603_1608Metric; LCSC C21190
R4: 1K5; R_0603_1608Metric
R5, R6: 27; R_0402_1005Metric; LCSC PN C25190
R7: 1K; R_0603_1608Metric; LCSC C21190
R8, R26: 10K; R_0603_1608Metric
R9, R10, R18, R19, R20, R21: 27K 1%; R_0603_1608Metric
R11, R13, R14, R15, R16, R22, R23: 1K; R_0603_1608Metric
R12: 1k; R_0603_1608Metric
R17: 4K7; R_0603_1608Metric
R24, R25: 360; R_0603_1608Metric
RV1: Az_Preset; Potentiometer_Alps_RK09K_Single_Horizontal
SW1, SW2: CW; SW_NKK_BB15AH
U1: ADUM3160; SOIC-16W_7.5x10.3mm_P1.27mm
U2: STM32F405RGTx; LQFP-64_10x10mm_P0.5mm
U3, U4, U5: CPC1966
U6: NDP6802SF-50; SOT-89-3
U7: AP2112K-3.3; SOT-23-5
Y1: 12M; Crystal_SMD_2016-4Pin_2.0x1.6mm

Connections:
/3V3: RV1.1
/5V: C30.1, R26.1, U6.1 (OUT), U7.1 (VIN)
/26VAC: C29.1, D7.2 (A), D12.2 (A2), J3.1, U3.3, U4.3, U5.3
/36VDC: C19.1, C26.1, D7.1 (K), R17.2, U6.3 (IN)
/+3V3: C5.1, C8.1, C11.1, C14.1, C16.1, FB2.1, R24.1, R25.1, U2.19 (VDD), U2.32 (VDD), U2.48 (VDD), U2.64 (VDD)
/+3v3: C7.1, C9.1, C33.1, C34.1, U1.12 (PIN), U1.14 (VDD2), U1.16 (VBUS2), U7.5 (VOUT)
/AVCC: C17.1, C18.1, FB2.2, U2.13 (VDDA)
/AzPre: RV1.2
/Brake: D15.2 (A2), J3.2, U5.4
/BrakeMCU: R15.1, R16.1
/CCW: SW2.1 (A)
/CW: SW1.1 (A)
/Cap1: J2.2, J3.9
/Cap2: J2.1, J3.5
/D+: U1.11 (DD-), U2.45 (PA12)
/D-: U1.10 (DD+), U2.44 (PA11)
/Flt_W+: C24.1, D6.2 (K), R9.1
/Flt_W-: C25.1, D6.1 (K), R10.1
/LED: D5.2 (A)
/Left: D13.2 (A2), J3.7, U3.4
/LeftMCU: R11.1, R12.1
/Pot+: C31.2, D16.2 (A2), J3.4, R22.2, R24.2
/Pot-: C32.2, D17.2 (A2), J3.8, R23.2, R25.2
/Right: D14.2 (A2), J3.3, U4.4
/RightMCU: R13.1, R14.1
/VBUS: C2.1, FB1.2, U1.1 (VBUS1)
GND: C4.2, C5.2, C6.2, C7.2, C8.2, C9.2, C10.2, C11.2, C12.2, C13.2, C14.2, C15.2, C16.2, C17.2, C18.2, C19.2, C20.2, C21.2, C22.2, C23.2, C26.2, C29.2, C30.2, C31.1, C32.1, C33.2, C34.2, D3.1 (K), D6.3 (A), D8.1 (K), D9.1 (K), D10.1 (K), D11.1 (K), D12.1 (A1), D13.1 (A1), D14.1 (A1), D15.1 (A1), D16.1 (A1), D17.1 (A1), J3.6, J3.10, R7.2, R8.1, R20.2, R21.2, RV1.3, SW1.2 (B), SW2.2 (B), U1.9 (GND2), U1.13 (SPD), U1.15 (GND2), U2.12 (VSSA), U2.18 (VSS), U2.28 (PB2), U2.63 (VSS), U3.1, U4.1, U5.1, U6.2 (GND), U7.2 (GND), Y1.2, Y1.4
GNDD: C1.2, C2.2, C3.2, D1.2 (A), D2.2 (A), D4.1 (K), J1.A1 (GND), J1.A12 (GND), J1.B1 (GND), J1.B12 (GND), J1.S1 (SHIELD), R1.1, R2.1, U1.2 (GND1), U1.5 (SPU), U1.8 (GND1)
unnamed: C20.1, C22.1, R9.2, R18.1
unnamed: C21.1, C23.1, R10.2, R19.1
unnamed: C24.2, C27.1, R20.1
unnamed: C25.2, C28.1, R21.1
unnamed: C27.2, R18.2, R22.1
unnamed: C28.2, R19.2, R23.1
unnamed: C3.1, D1.1 (K), J1.A6 (D+), J1.B6 (D+), R6.2
unnamed: C1.1, D2.1 (K), J1.A7 (D-), J1.B7 (D-), R5.2
unnamed: D3.2 (A), R4.2
unnamed: D4.2 (A), R3.2
unnamed: D5.1 (K), R7.1
unnamed: D8.2 (A), R11.2
unnamed: D9.2 (A), R13.2
unnamed: D10.2 (A), R15.2
unnamed: D11.2 (A), R17.1
unnamed: FB1.1, J1.A4 (VBUS), J1.A9 (VBUS), J1.B4 (VBUS), J1.B9 (VBUS), R3.1
unnamed: J1.A5 (CC1), R1.2
unnamed: J1.B5 (CC2), R2.2
unnamed: R12.2, U3.2
unnamed: R14.2, U4.2
unnamed: R16.2, U5.2
unnamed: C4.1, U1.3 (VDD1), U1.4 (PDEN)
unnamed: R6.1, U1.7 (UD+)
unnamed: R5.1, U1.6 (UD-)
unnamed: R8.2, U2.60 (BOOT0)
unnamed: C6.1, U2.7 (NRST)
unnamed: C10.1, U2.5 (PH0), Y1.1
unnamed: C13.1, U2.6 (PH1), Y1.3
unnamed: C12.1, U2.31 (VCAP_1)
unnamed: C15.1, U2.47 (VCAP_2)
unnamed: R26.2, U7.3 (EN)

Notes on the sheet:
HAM-M Connector 1 - Return 2 - Brake 3 - Pot + 4 - Cap Left 5 - Motor Right 6 - Motor Left 7 - Pot - 8 - Cap Right
V4.1
Brake Current ~2 amps Motor Current ~0.7 amps, no load
Lightpipe 4 high
Notch filter, 60 Hz, passive twin T

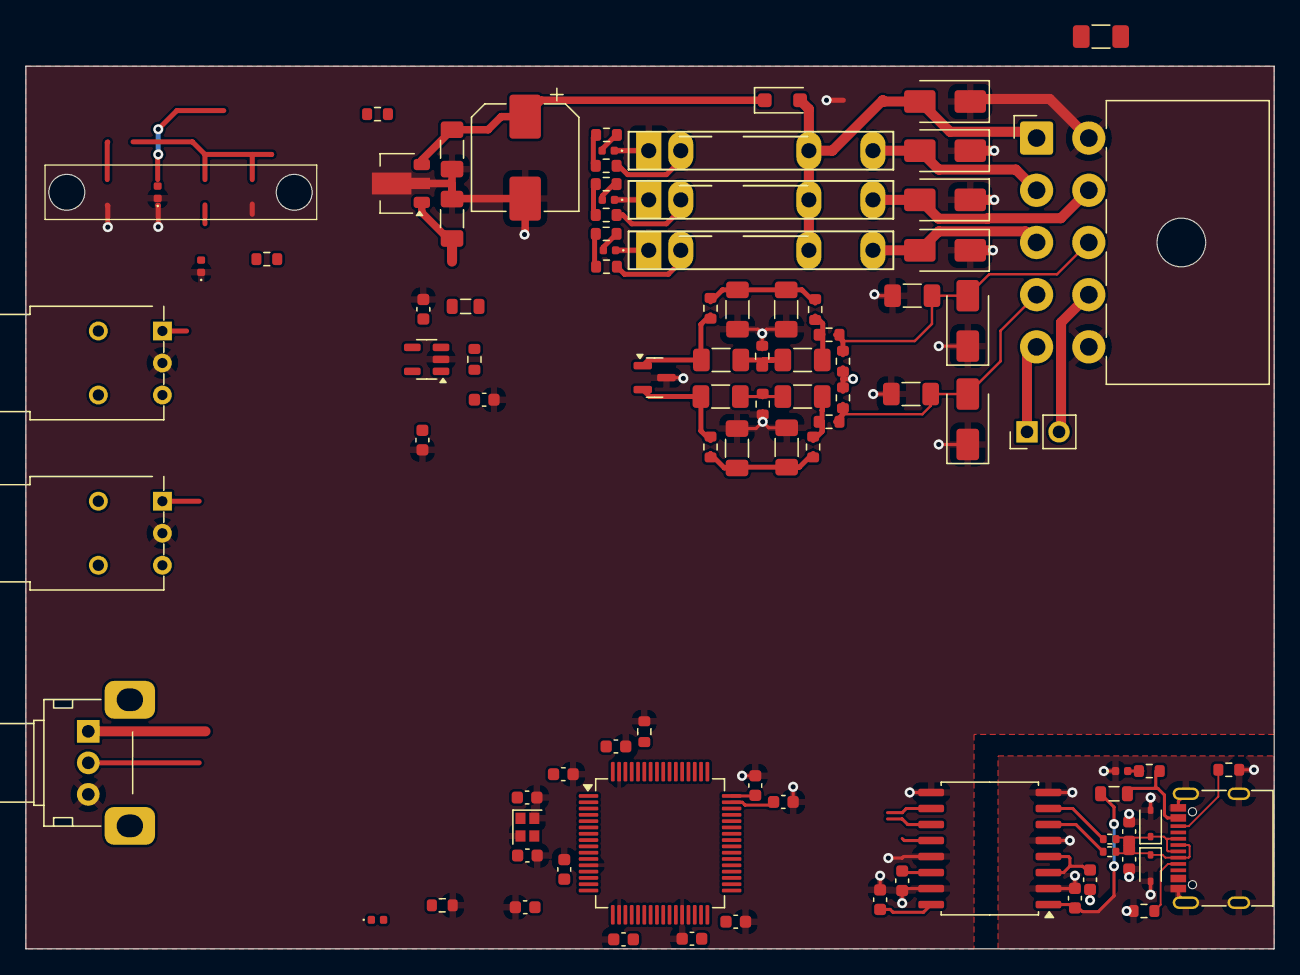
[picture p19: board Rotator-Controller-V4.kicad_pcb from above]

Board: 2 copper layers, 99.0 x 70.0 mm, 94 parts (0 on the bottom side), 54 nets.
