wa1hco/rotator_controller/(commit log)

2024-06-20 Added files Update board outline based on measurements Moved connectors to new board outline
2024-06-21 Moved Teensy into position, adjusted related traces
2024-06-26 Mid layout of smaller pcb with separately mounted cap still need to assign cap connector Added 4 high light pipe and 0805 LEDs, need to create footprint
2024-06-27 Simplified symbol and footprint for Teensy4.0 to remove unused pins Corrected error where footprints reverted to through-hole (mystery)
2024-07-14 Homing in on final release add ground to pot and button mounting pads added start of dimensions and front panel sketch
2024-08-29 Created V3 branch for new board with 3.6V zeners for protection
2025-09-28 Merged software from V2 Started looking at using STM32 series MCU instead of teensy
2025-09-30 More work on schematic Started software conversion to STM32F405 MCU
2026-10-11 Document the imported V4 board and drop unused library rows.
    The project-local tables still use ${KIPRJMOD}, and now only name the
    LightPipe, NKK, and RotatorController libraries that this tree ships.
2026-10-11 Add the C++ core, simulator, design docs, and CI.
    The host firmware build and unit tests are the required green check.
    KiCad ERC and DRC run in a KiCad 9 container and upload reports without
    failing on the known V4 violations.
2026-10-11 Run the KiCad CI container as root so checkout can write.
    The kicad/kicad image defaults to uid 1000, which cannot write the
    Actions workspace.
2026-10-11 Record JLCPCB sourcing and the STM32F407 plus LAN8720 choice.
    Ethernet is standard and the W5500 path is dropped. The KiCad
    schematic and PCB are unchanged; symbols will gain LCSC and Mouser
    fields when the board is re-laid-out.
2026-10-12 Record the configuration model, web UI, and programming hardware.
    Replace compile-time feature flags with a board file, always-on
    features, and versioned settings. Document grammar-shared GS-232,
    a custom A/B bootloader, and the BOOT, USB-C, and Tag-Connect parts
    the next layout has to add.
2026-10-12 Add the rotator catalog and the preset source file.
    The YAML is the firmware preset table. The catalog is the same data
    for reading, and its board implications are open hardware items.
2026-10-12 Add the Hammond 1455N1601 outline and end-plate drawings.
    The outline is its own KiCad project, not a change to the V4 board.
    The CDE run capacitor is a 100 µF flat part plus a 33 µF upright part.
2026-10-12 Generate enclosure machining drawings from the layout.
    Panel sheets no longer live on the outline board. A script reads
    Panel, PanelCutout, and PanelZ from footprints and writes 1:1 plate
    drawings, including the top-wall drills from the triac bar.
2026-10-12 Record the AC version's single 26 VAC feed and rotor-return ground.
    Logic power is half-wave rectified from that feed, then a non-isolated buck and an LDO. The rear-panel Powerpole default is a pigtail gland; the bracket cutout stays TBD.
2026-10-12 Add the F407 rotor-drive sheet.
    First sheet of hardware/controller-f407: the CDE/Yaesu connector, motor run caps, interlocked triac drive, ARM relay, and the 26 VAC tap. The imported V4 tree is unchanged.
2026-10-13 starting to clean up ai generated schematics
2026-10-14 Separate overlapping F407 text without moving Jeff's placements (#6)
    * Separate overlapping text on the F407 rotor-drive sheet.
    Reference, value, and label text that crossed a symbol body or another
    label moves to the nearest clear 1.27 mm position, or a label spin, or a
    short stub. Fields and labels that were already clear are unchanged.
    * Retidy F407 text on top of Jeff's schematic cleanup.
    Fields and labels he edited in f665ffd stay byte-identical. The tool
    moves only the other rotor-drive text that still overlaps.
    ---------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
2026-10-16 Clear overlapping text on the off-page F407 rotor symbols. (#7)
    Symbols outside the USLedger border are not placed yet, so the owner
    freeze is lifted there. In-page placements stay where Jeff left them.
2026-10-16 Layout schematic...that was a lot of work after the AI dropped everything randomly
2026-10-17 nearly complete schematic for discrete logic version
2026-10-18 Gate the rotor triacs with ARM_OK only (#10)
    * Remove the discrete direction interlock from the rotor drive sheet.
    CW_GATE, CCW_GATE, and BRK_GATE now require only ARM_OK. The 74LVC14,
    the direction AND gates, and the hold RC are gone. D2 stays on AC_FUSED,
    after the fuse and before the relay.
    * Tie the ROTOR_RETURN sheet pin to GNDPWR.
    A short wire joins the existing hierarchical label to the ground symbol
    on C23, so the parent pin and logic ground are one net. The sheet title
    names that net ROTOR_RETURN = GNDPWR.
    C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
2026-10-18 Propose a Drive MCU in place of the discrete interlock (#9)
    * Propose a Drive MCU in place of the discrete interlock.
    ADR 0020 (Proposed) and the design note give the deadlines to a
    second MCU and leave the F407 as the Station. The axis behavior is
    a state diagram plus a full state-by-event table. The schematic and
    the firmware are unchanged.
    * Record the owner's Drive and Station decisions.
    Names are confirmed. An AC axis is on or off, so the ramp states
    pass through with ramp time 0. K1 stays, one relay, because it is
    the only way to clear a shorted triac. TR1 stays as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
2026-10-19 Drive the rotor gates from the MCU, with no supervisor and no STOP pin (#11)
    * Drive the rotor gates from the MCU and clamp only the relay.
    Remove the remaining AND gates so the Drive pins switch the triacs and the relay FET, with pulldowns holding a high-Z pin off. Keep the TPS3823 as a hard clamp on the relay gate. Record the STM32G431 brownout, reset, and option-byte findings in ADR 0021.
    * Drop the Drive supervisor and the STOP pin.
    The TPS3823, Q8, Q9, and their passives leave the rotor sheet. ARM_EN drives the relay FET, with the pulldowns holding a high-Z gate off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
2026-10-19 Rotor drive layout tweaks; add STM32G431RB datasheet
2026-10-19 Add the Drive MCU and analog sheets, and tidy the triac page (#12)
    * Add the Drive MCU and analog sheets, and tidy the triac page.
    Tie the dangling ROTOR_RETURN label to GNDPWR, clear overlapping field
    text without moving owner-placed parts, and hang drive_mcu and
    analog_input off the root. Pin assignment follows ADR 0021.
    * Rename the relay net back to ARM_EN and drop the dangling stub.
    The owner's label text is ARM_EN again, in place. One pulldown remains
    on each gate line. TR1 conditioning stays on the rotor sheet.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
2026-10-20 Remove the placeholder motor-cap footprints that sat on C6 and C7. (#13)
    C_MOTOR1 and C_MOTOR2 had no nets and overlapped the real run capacitors, which produced clearance, solder-mask, and co-located-hole DRC hits. HS1, the aluminum heat bar, is mechanical: mark it not in the schematic and keep it out of the BOM and position files.
2026-10-20 Add a 60 Hz twin-T on each pot sense line.
    The shared rotor return can carry several volts of 60 Hz, so each sense line is 1k, then 121k/60.4k/22n twin-T, then the existing 10k/100nF, then the BAT54 clamps. Elevation J5 is a 3-pin connector valued ELEVATION ROTOR. Owner text on the analog sheet is recorded and not moved.
2026-10-20 Move the outline motor-run caps to the bottom side.
    The top of the Hammond slot-6 board is crowded, so C_MOTOR1 and C_MOTOR2 hang below the board. The heat bar stays on top. Both footprints move to B.Cu, fab and courtyard move to B.Fab and B.CrtYd, and the flat-cap lead bend reverses up into the board. A +3.6 mm shift in +y keeps the 20.3 mm body outside the 8.5 mm bottom-edge strip and the corner bosses.
2026-10-20 Flip C6 and C7 to the bottom of the controller board.
    The two motor-run caps stay on their current holes. Those holes already clear the slot-6 bottom edge strip, and the outline's board coordinates are occupied by the heatsink bar and the parts in front of it. Pads stay through-hole. Fab and courtyard move to the back, and the flat-cap leads bend up into the board so they can be soldered from the top.
