wa1hco/rotator_controller/(notices)

Notices in the files:
hardware/controller/Rotator-Controller-V4.kicad_pcb:
Creative Commons License
